sjfricke/MrTruman/README.md

# ECE453Project

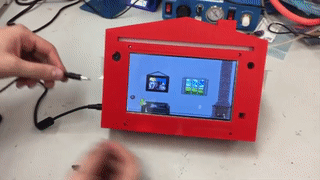
[picture p1: speakers.gif]
Speakers


https://www.youtube.com/watch?v=rOoYeWgOzVc
