sjfricke/MrTruman/Seahaven/docs/project_block_diag.tiff

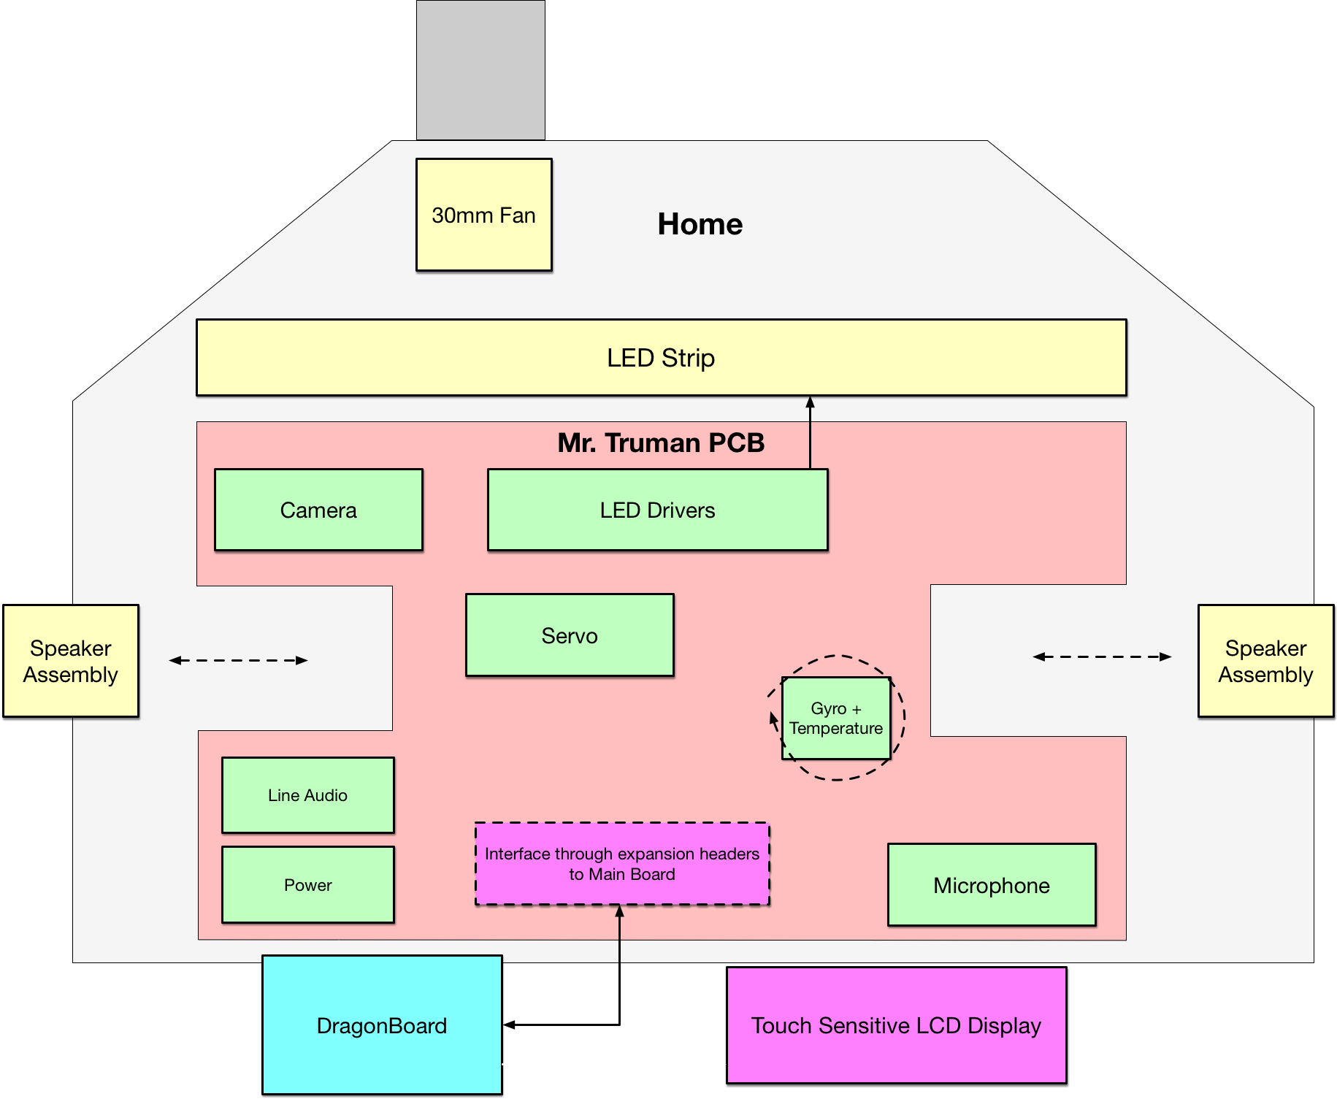
Seahaven/docs/project_block_diag.tiff
