sjfricke/MrTruman/Seahaven/website/res/img/fire_place.png

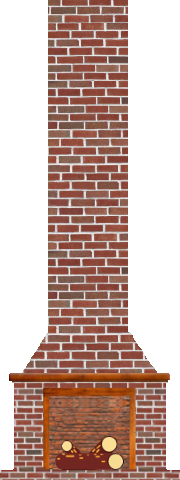
Seahaven/website/res/img/fire_place.png
