sjfricke/MrTruman/Seahaven/website/res/img/flash.png

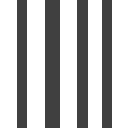
Seahaven/website/res/img/flash.png
