sjfricke/MrTruman/Seahaven/website/res/img/frame.png

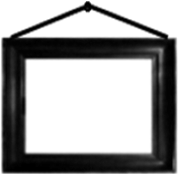
Seahaven/website/res/img/frame.png
