sjfricke/MrTruman/Seahaven/website/res/img/picture.png

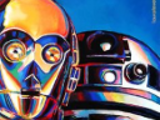
Seahaven/website/res/img/picture.png
