sjfricke/MrTruman/Seahaven/website/res/img/wall_texture_0.jpg

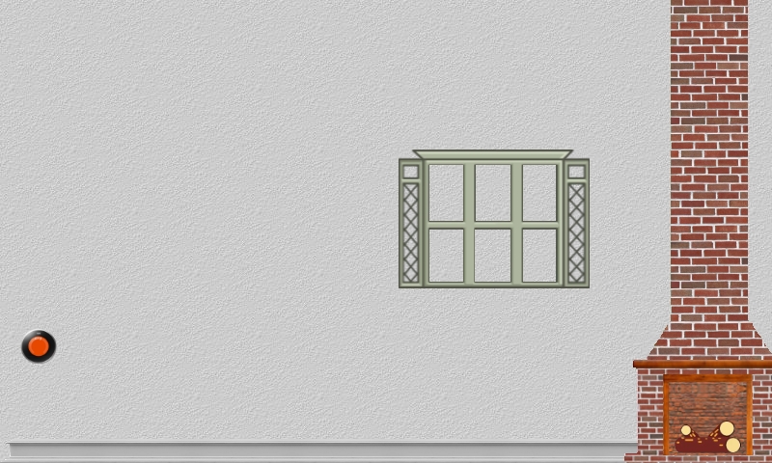
Seahaven/website/res/img/wall_texture_0.jpg
