sjfricke/MrTruman/Seahaven/website/res/img/wall_texture_1.jpg

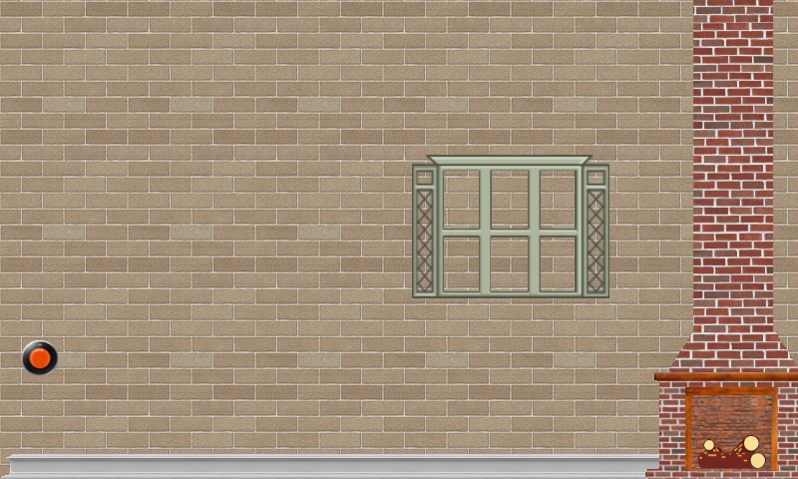
Seahaven/website/res/img/wall_texture_1.jpg
