sjfricke/MrTruman/Seahaven/website/res/img/wall_texture_2.jpg

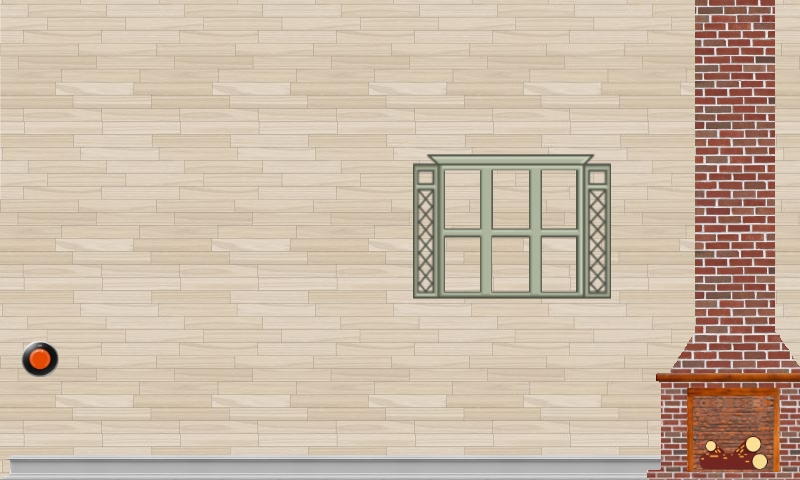
Seahaven/website/res/img/wall_texture_2.jpg
