sjfricke/MrTruman/Seahaven/website/res/img/wall_texture_3.jpg

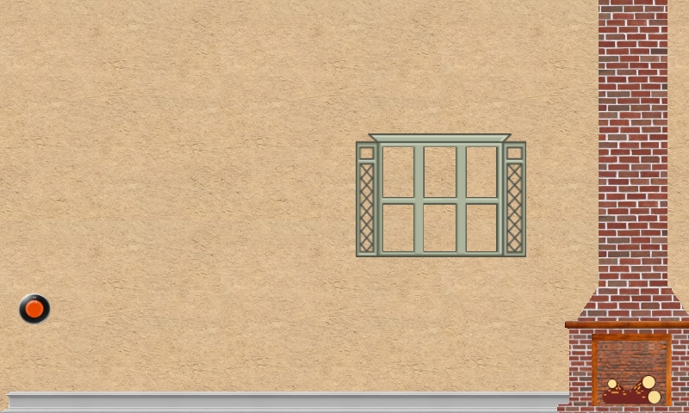
Seahaven/website/res/img/wall_texture_3.jpg
