sjfricke/MrTruman/Seahaven/website/res/img/wall_texture_4.jpg

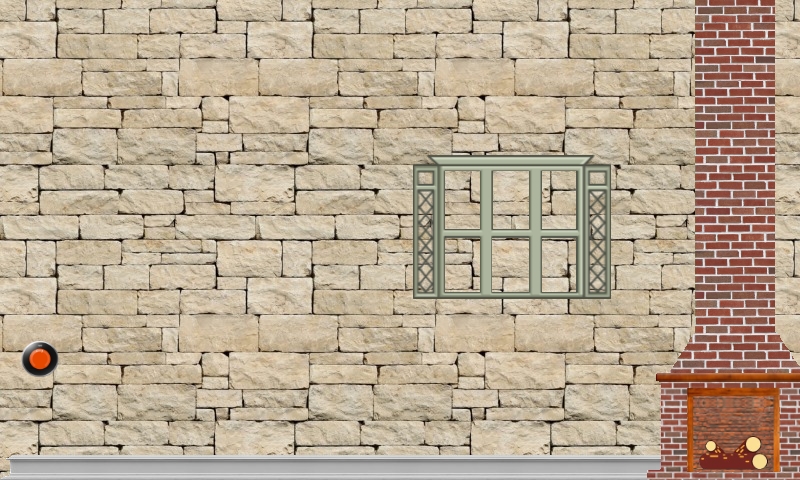
Seahaven/website/res/img/wall_texture_4.jpg
