sjfricke/MrTruman/Seahaven/website/res/img/window.png

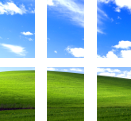
Seahaven/website/res/img/window.png
