sjfricke/MrTruman/Seahaven/website/res/json/spineboy_tex.png

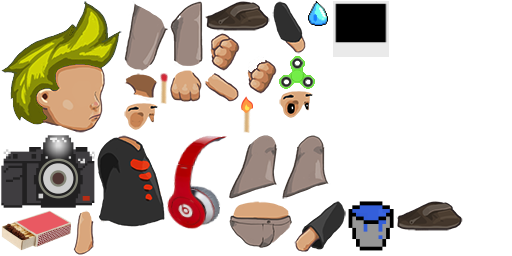
Seahaven/website/res/json/spineboy_tex.png
