sjfricke/MrTruman/Seahaven/website/res/spritesheet/fire_animated.png

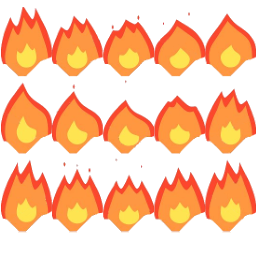
Seahaven/website/res/spritesheet/fire_animated.png
