sjfricke/MrTruman/Seahaven/website/res/spritesheet/flash_animated.png

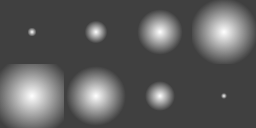
Seahaven/website/res/spritesheet/flash_animated.png
