sjfricke/MrTruman/ALTIUM/MRTRUMAN/Project Outputs for MRTRUMAN/MRTRUMAN_BOM.xlsx

Manufacturer Part Number | Manufacturer | Description | Designator | Quantity | LibRef
MJ-3523-SMT-TR | CUI | 3.50mm (0.141", 1/8", Mini Plug) - Headphone Phone Jack Mono Connector Solder | AUX1 | 1 | CP-3523MJCT-ND
C2012X7T2E104K125AE | TDK | Cap Ceramic 0.1uF 250V X7T 10% SMD 0805 125C Plastic T/R | C1, C2, C5, C6, C20, C27, C29, C30, C32, C36, C37, C38, C41, C42, C46 | 15 | CAP_0805_.1u_250V
160R15X106KV4E | Johanson Dielectrics | Cap Ceramic 10uF 16V X5R 10% SMD 0805 85C T/R | C3, C7, C22, C31, C33, C34, C35, C39, C40, C43, C44, C45, C47 | 13 | CAP_0805_10u_16V
UWT1E221MNL1GS | Nichicon | CAP ALUM 220UF 20% 25V SMD | C4, C8, C9, C10, C11, C12, C13 | 7 | CAP_RAD_220u_25V
C2012X7S2A105K125AE | TDK | CAP CER 1UF 100V X7S 0805 | C14, C16, C24 | 3 | CAP_0805_1u_100V
CL21A226MAQNNNE | Samsung | 22µF ±20% 25V X5R Ceramic Capacitor -55°C ~ 85°C Surface Mount, MLCC 0805 (2012 Metric) 0.079" L x 0.049" W (2.00mm x 1.25mm) | C15, C25 | 2 | CAP_0805_22u_25V
CGJ4J2X7R2A223K125AA | TDK | CAP CER 0.022UF 100V X7R 0805 | C17, C19, C21, C26 | 4 | CAP_0805_22n_100V
GRM32ER61A107ME20L | Murata | Cap Ceramic 100uF 10V X5R 20% SMD 1210 85C Embossed T/R | C18, C23, C28 | 3 | CAP_1210_100u_10V
1-1734248-5 | TE Connectivity | CONN FPC VERT 15POS 1.00MM SMD | CAM1 | 1 | A101418CT-ND
SML-LXR85SIC-TR | Lumex | Standard LEDs - SMD Surface Mount LEDs | D1, D2, D3, D4 | 4 | LED_RED_636nm
WP154A4SUREQBFZGC | Kingbright | WP154A4SUREQBFZGC | D5, D6, D7, D8, D9, D10, D11, D12, D13, D14 | 10 | RGB_LED
N/A | N/A - Just Thru Hole Vias | 4 Position Thru Hole Connection | DPWR1 | 1 | Display_Power
ASB0305MA-CA8Z | Delta Design | FAN AXIAL 30X10MM 5VDC WIRE | FAN1 | 1 | ASB0305MA-CA8Z
MFU0805FF01000P100 | Vishay | FUSE 1.00A 0805 VFAST SMD | FUSE1 | 1 | FUSE_0805_1A_32VDC
57202-G52-20LF | Amphenol FCI | 40 Positions Header, Unshrouded Connector 0.079" (2.00mm) Surface Mount Gold, GXT™ | J1 | 1 | DragonBoard_LOW_SPEED
61083-064402LF | Amphenol FCI | 60 Position Connector Plug, Center Strip Contacts Surface Mount Gold | J2 | 1 | DragonBoard_HIGH_SPEED
0791091007 | Molex | Conn Socket Strip RCP 16 POS 2mm Solder ST SMD Tube | J3 | 1 | DragonBoard_ANALOG
SPU0410HR5H-PB | Knowles | MIC MEMS ANALOG OMNI -42DB | MIC1 | 1 | SPU0410HR5H-PB
EJ503A | Memory Protection Devices | DC Barrel Jack 2.1mm x 5.5mm 12V 5A | PWR1 | 1 | EJ503A
RC0805FR-071M74L | Yageo | RES SMD 1.74M OHM 1% 1/8W 0805 | R1, R21 | 2 | RES_0805_1.74M
RC0805FR-076K2L | Yageo | Yageo RC0805 Series Thick Film Surface Mount Resistor 0805 Case 6.2k 1% 0.125W 100ppm/C | R2 | 1 | RES_0805_6.2K
RC0805FR-071M43L | Yageo | RES SMD 1.43M OHM 1% 1/8W 0805 | R3 | 1 | RES_0805_1.43M
RC0805JR-072KL | Yageo | RES SMD 2K OHM 5% 1/8W 0805 | R4, R23 | 2 | RES_0805_2K
ERJ-6ENF2322V | Panasonic ECG | RESISTOR, THICK FILM, 23.2KOHM, 125mW, ± 1% | R5, R14 | 2 | RES_0805_23.2K
RC0805FR-0763K4L | Yageo | RES SMD 63.4K OHM 1% 1/8W 0805 | R6 | 1 | RES_0805_63.4K
ERJ-6ENF2263V | Panasonic ECG | Res Thick Film 0805 226K Ohm 1% 1/8W ±100ppm/C Molded SMD Punched Carrier T/R | R7 | 1 | RES_0805_226K
CRCW0805549KFKEA | Vishay | RES SMD 549K OHM 1% 1/8W 0805 | R8 | 1 | RES_0805_549K
RC0805FR-0711K8L | Yageo | RES SMD 11.8K OHM 1% 1/8W 0805 | R9, R17, R29 | 3 | RES_0805_11.8K
RC0805FR-07787RL | Yageo | RES SMD 787 OHM 1% 1/8W 0805 | R10, R11, R20, R22 | 4 | RES_0805_787
RC0805FR-075K23L | Yageo | Thick Film Resistors 5.23K OHM 1% | R12 | 1 | RES_0805_5.23K
RC0805FR-071KL | Yageo | RES SMD 1K OHM 1% 1/8W 0805 | R13 | 1 | RES_0805_1K
ERJ-6ENF1003V | Panasonic ECG | Res Thick Film 0805 100K Ohm 1% 0.125W(1/8W) ±100ppm/C Molded SMD Automotive Punched T/R | R15 | 1 | RES_0805_100K
ERJ-6ENF1134V | Panasonic | Res Thick Film 0805 1.13M Ohm 1% 1/8W 100ppm/C Molded SMD Punched Carrier T/R | R16 | 1 | RES_0805_1.13M
RC0805FR-07255KL | Yageo | RES SMD 255K OHM 1% 1/8W 0805 | R18 | 1 | RES_0805_255K
RC0805FR-07887KL | Yageo | Thick Film Resistors - SMD 887K OHM 1% | R19 | 1 | RES_0805_887K
RMCF0805FT499R | Stackpole Electronics | Res Thick Film 0805 499 Ohm 1% 0.125W(1/8W) ±100ppm/C Molded SMD Automotive T/R | R24, R26 | 2 | RES_0805_499
RMCF0805JT1K20 | Stackpole Electronics | Res Thick Film 0805 1.2K Ohm 5% 0.125W(1/8W) ±200ppm/C Molded SMD Automotive T/R | R25, R28 | 2 | RES_0805_1.2K
RC0805JR-070RL | Yageo | RES, THICK FILM, 0R, 0.125W, 0805 | R27, R30, R31, R32, R33 | 5 | RES_0805_JMP
RC0805FR-07309RL | Yageo | RES SMD 309 OHM 1% 1/8W 0805 | R34, R35, R40, R41, R46, R47, R52, R53, R58, R61 | 10 | RES_0805_309
RC0805FR-07169RL | Yageo | RES SMD 169 OHM 1% 1/8W 0805 | R36, R37, R38, R39, R42, R43, R44, R45, R48, R49, R50, R51, R54, R55, R56, R57, R59, R60, R62, R63 | 20 | RES_0805_169
61300311121 | Wurth Electronics | Board-To-Board Connector, Vertical, WR-PHD Series, Through Hole, Header, 3 Contacts, 2.54 mm | SERVO1 | 1 | Servo_Header
CDS-27204-L100 | CUI | 4 Ohm Magnetic Speaker 2W 20Hz ~ 20kHz Top Rectangular 93dB | SPKR1, SPKR2 | 2 | CDS-27204-L100
1625854-4 | TE Connectivity | Testpoint_1206 | TP1, TP2, TP3, TP4, TP5, TP6, TP7, TP8, TP9, TP10, TP11, TP12, TP13, TP14, TP15, TP16, TP17, TP18, TP19, TP20, TP21, TP22, TP23, TP24, TP25, TP26, TP27, TP28, TP29, TP30, TP31, TP32, TP33, TP34, TP35, TP36, TP37, TP38, TP39, TP40, TP41, TP42, TP43, TP44, TP45, TP46, TP47, TP48, TP49, TP50, TP51, TP52, TP53, TP54, TP55, TP56, TP57, TP58, TP59, TP60, TP61, TP62, TP63, TP64, TP65, TP66, TP67, TP68, TP69, TP70, TP71, TP72, TP73, TP74, TP75, TP76, TP77, TP78, TP79, TP80, TP81, TP82, TP83, TP84, TP85, TP86, TP87, TP88, TP89, TP90, TP91, TP92, TP93, TP94, TP95, TP96 | 96 | TP
TXS0108EPWR | Texas Instruments | TRANSLATOR, VOLTAGE, 8BIT, 20TSSOP | U1, U2 | 2 | TXS0108
LMZ12003TZ-ADJ/NOPB | Texas Instruments | POWER MODULE, TO-PMOD-7, FULL REEL | U3, U5 | 2 | LMZ12003
TPS3779BDBVT | Texas Instruments | Voltage Detector, Active-Low, Push-Pull Reset, 2-Monitors, 1.5V-6.5Vin, SOT-23-6 | U4, U6 | 2 | TPS3779BDBVR
LSM6DS3HTR | STMicroelectronics | Accelerometer and Gyroscope 14-Pin LGA T/R | U7 | 1 | LSM6DS3HTR
PCA9685PW,118 | NXP Semiconductors | IC LED DRIVER RGBA 28-TSSOP | U8, U11, U12, U13 | 4 | PCA9685PW
AD7684BRMZRL7 | Analog Devices | IC ADC 16BIT 100KSPS DIFF 8MSOP | U9 | 1 | AD7684BRMZRL7CT-ND
AD8138ARZ-R7 | Analog Devices | SP Amp Differential ADC Driver Single ±5.5V/11V 8-Pin SOIC N T/R | U10 | 1 | AD8138ARZ-R7CT-ND
