sjfricke/MrTruman/3D_Prints/week06_draft/truman_06_full.stl

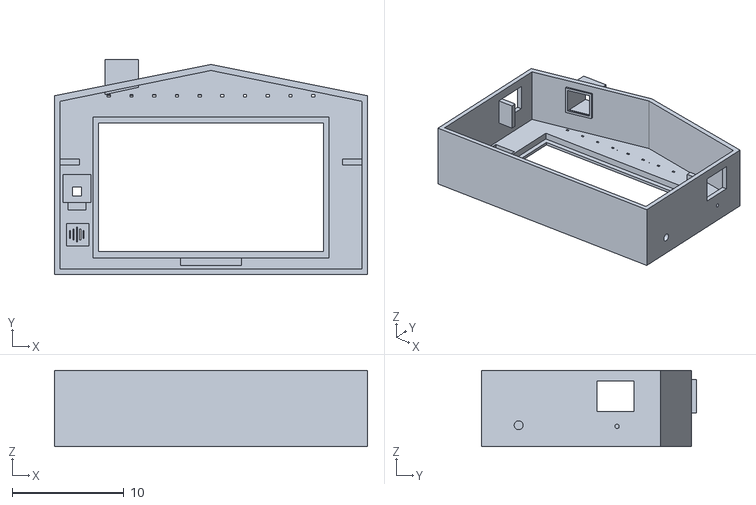
[picture p17: CAD file, 2017-11-06]
3D_Prints/week06_draft/truman_06_full.stl
28.0 x 19.2 x 6.80
