sjfricke/MrTruman/3D_Prints/Final_draft/back_plate_full.stl

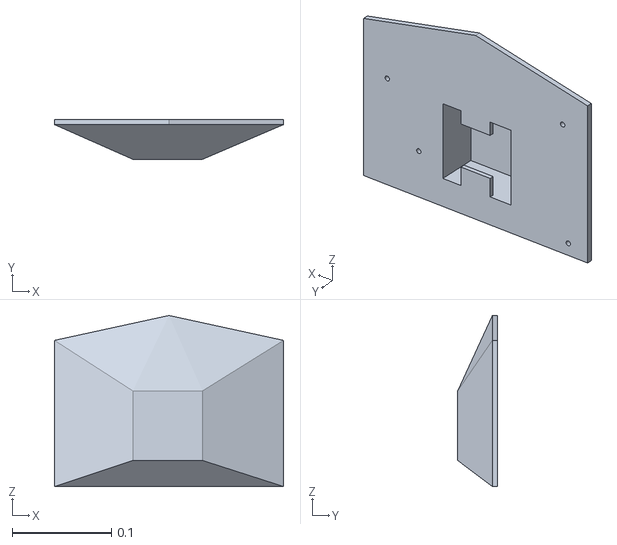
[picture p18: CAD file, 2017-11-27]
3D_Prints/Final_draft/back_plate_full.stl
0.231 x 0.04 x 0.172
