sjfricke/MrTruman/3D_Prints/Final_draft/house_front_full.stl

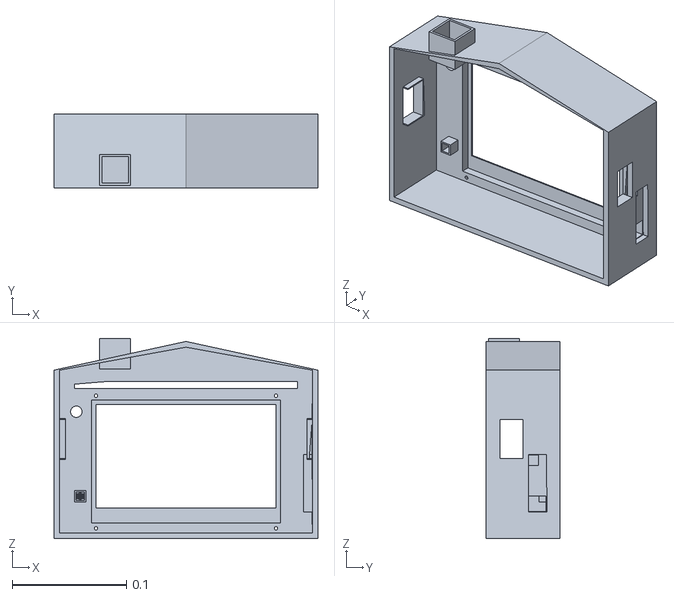
[picture p19: CAD file, 2017-11-27]
3D_Prints/Final_draft/house_front_full.stl
0.231 x 0.065 x 0.175
