sjfricke/MrTruman/3D_Prints/Final_draft/back_plate_left_test.stl

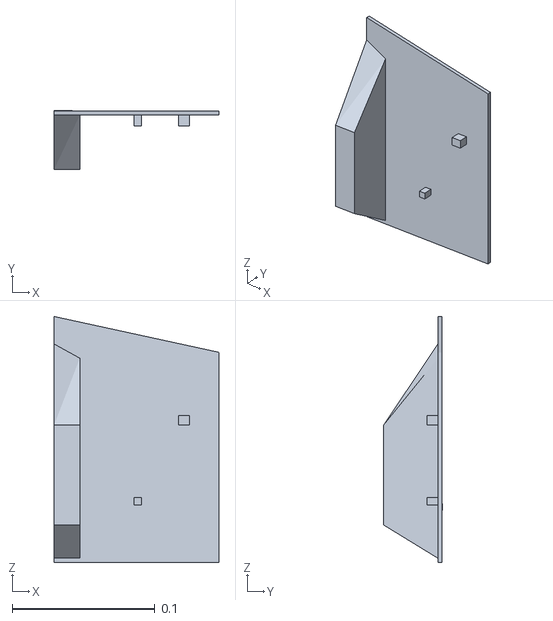
[picture p20: CAD file, 2017-11-29]
3D_Prints/Final_draft/back_plate_left_test.stl
0.116 x 0.0411 x 0.172
