sjfricke/MrTruman/3D_Prints/week05_draft/week05_draft_right_slim.stl

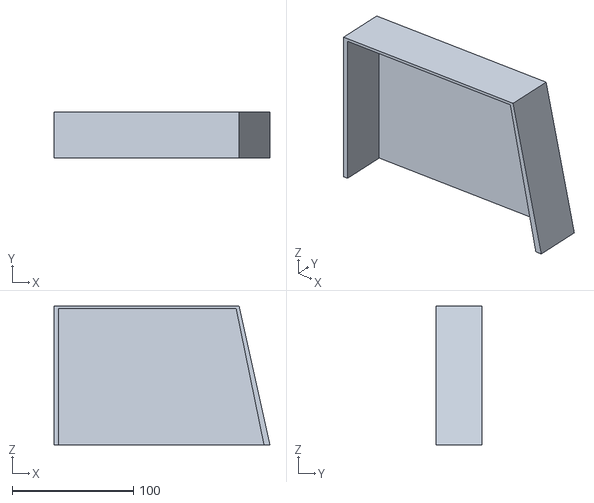
[picture p21: CAD file, 2017-11-06]
3D_Prints/week05_draft/week05_draft_right_slim.stl
177.8 x 38.1 x 114.3
