sjfricke/MrTruman/3D_Prints/Final_draft/awning.stl

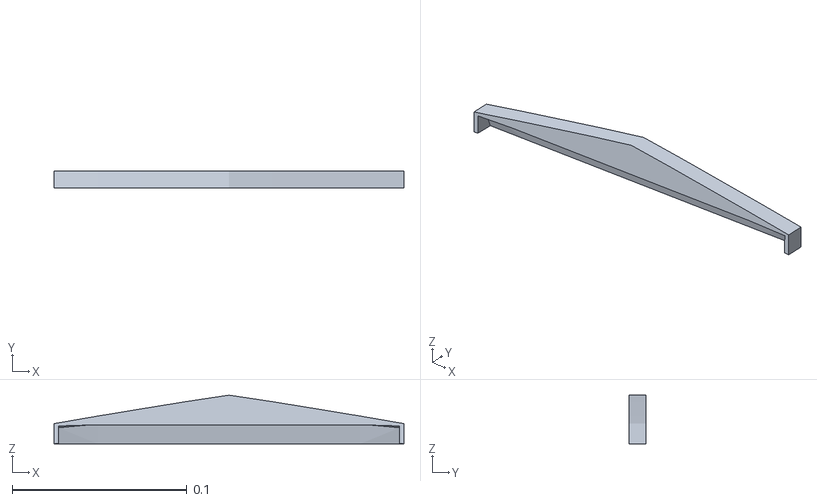
[picture p23: CAD file, 2017-11-29]
3D_Prints/Final_draft/awning.stl
0.2 x 0.01 x 0.0278
