sjfricke/MrTruman/3D_Prints/week05_draft/week05_draft_right.stl

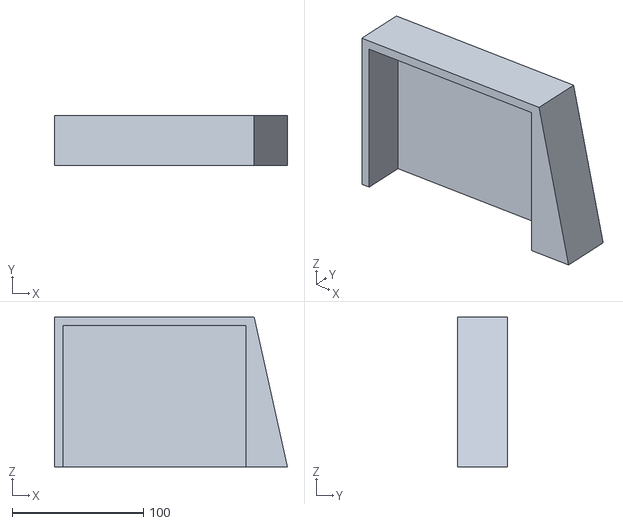
[picture p24: CAD file, 2017-11-06]
3D_Prints/week05_draft/week05_draft_right.stl
177.8 x 38.1 x 114.3
