sjfricke/MrTruman/3D_Prints/week06_draft/truman_06_Right.stl

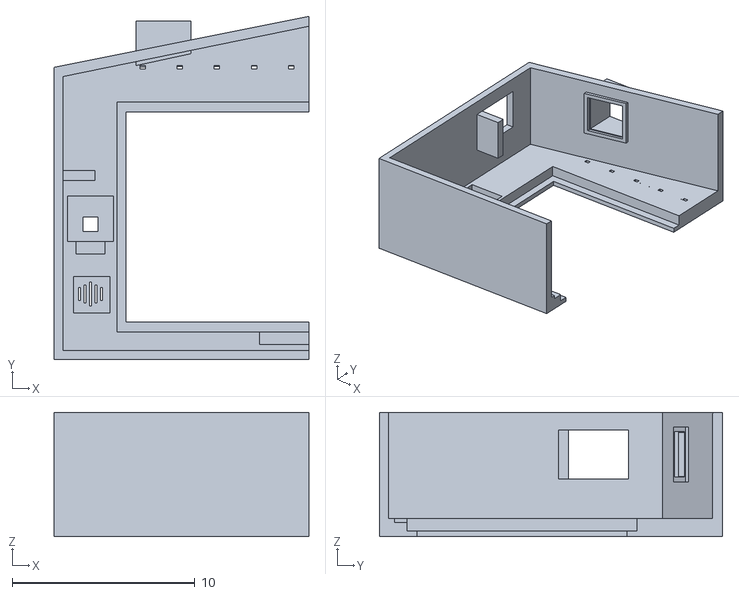
[picture p25: CAD file, 2017-11-06]
3D_Prints/week06_draft/truman_06_Right.stl
14.0 x 18.8 x 6.80
