sjfricke/MrTruman/3D_Prints/week05_draft/week05_draft_left.stl

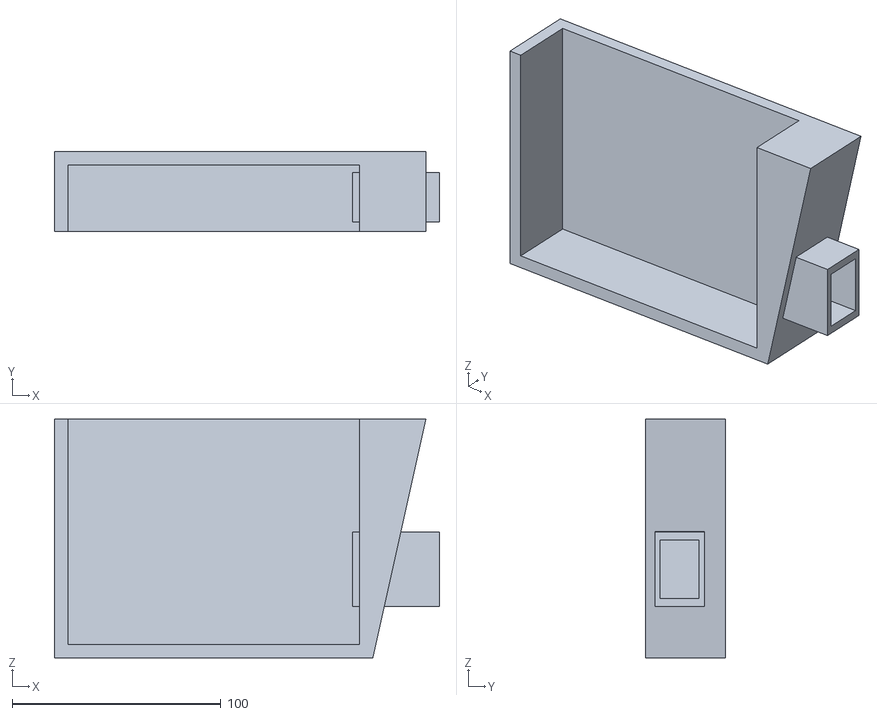
[picture p26: CAD file, 2017-11-06]
3D_Prints/week05_draft/week05_draft_left.stl
184.3 x 38.1 x 114.3
