sjfricke/MrTruman/3D_Prints/Final_draft/House_backplates.curaproject.3mf

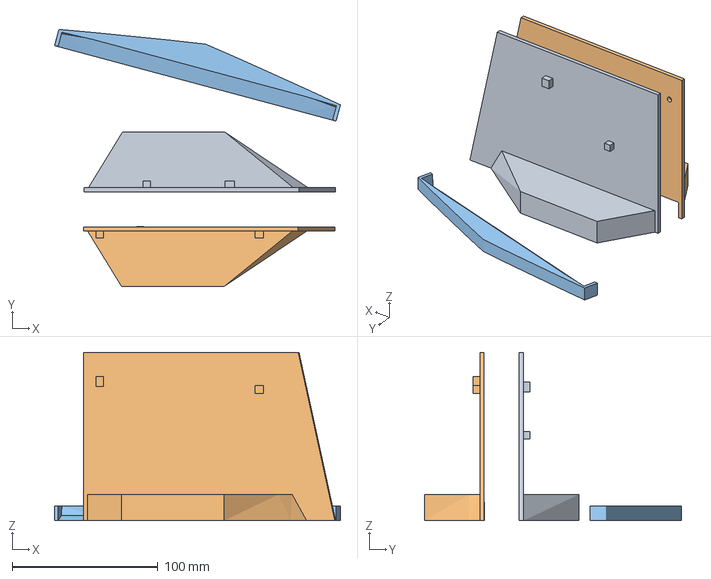
[picture p27: CAD file, 2017-11-29]
3D_Prints/Final_draft/House_backplates.curaproject.3mf
196.2 x 176.4 x 115.5 mm
