sjfricke/MrTruman/3D_Prints/week05_draft/week05_draft_left_slim.stl

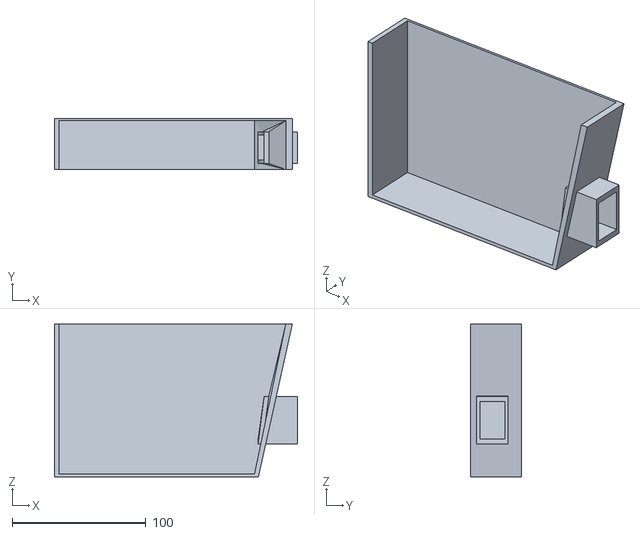
[picture p28: CAD file, 2017-11-06]
3D_Prints/week05_draft/week05_draft_left_slim.stl
181.6 x 38.1 x 114.3
