sjfricke/MrTruman/3D_Prints/Final_draft/House_Backplates_v2.curaproject.3mf

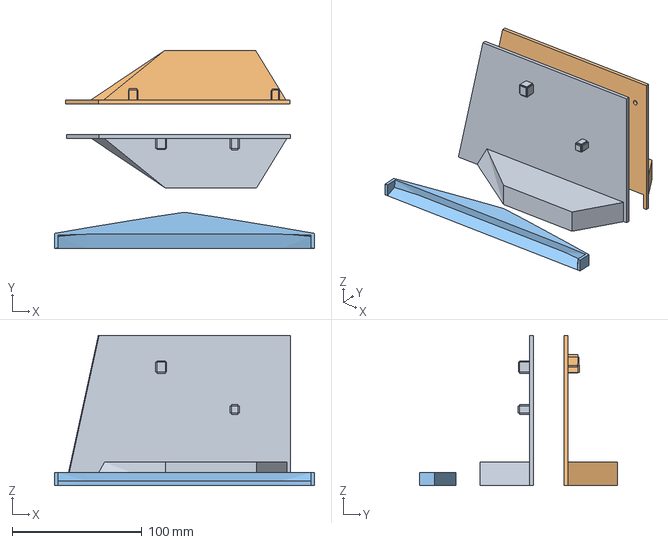
[picture p29: CAD file, 2017-11-29]
3D_Prints/Final_draft/House_Backplates_v2.curaproject.3mf
200.0 x 152.2 x 115.5 mm
