sjfricke/MrTruman/3D_Prints/Final_draft/House_front_cura.curaproject.3mf

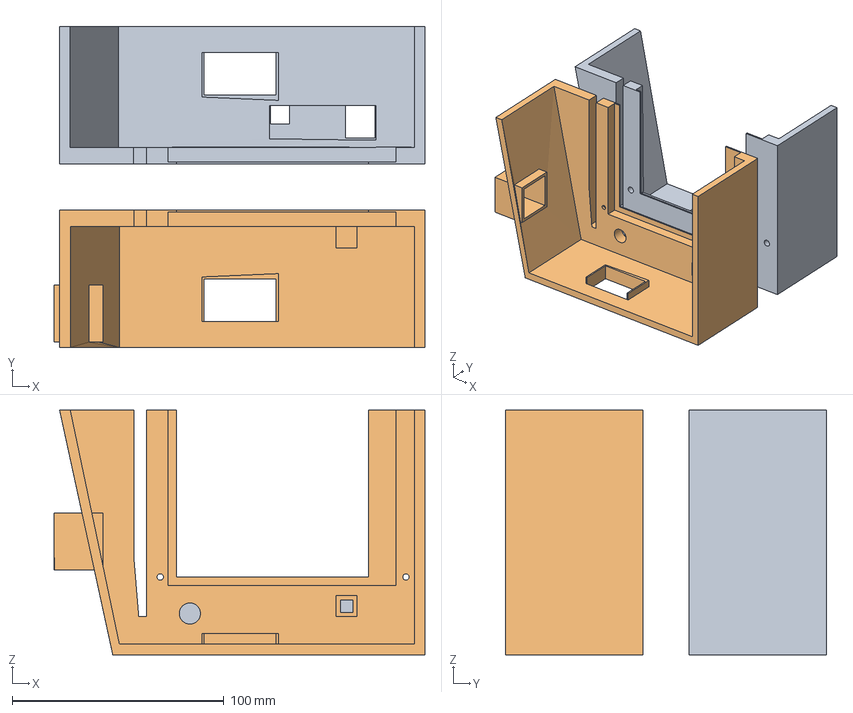
[picture p30: CAD file, 2017-11-27]
3D_Prints/Final_draft/House_front_cura.curaproject.3mf
175.2 x 151.5 x 115.5 mm
