sjfricke/MrTruman/3D_Prints/Final_draft/speaker.stl

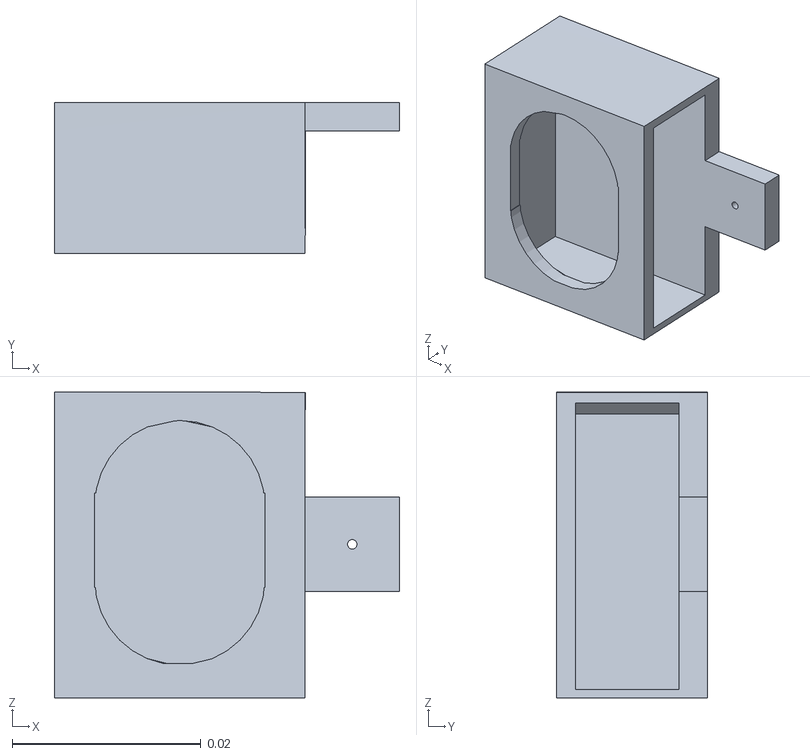
[picture p31: CAD file, 2017-11-27]
3D_Prints/Final_draft/speaker.stl
0.0365 x 0.016 x 0.0324
