sjfricke/MrTruman/3D_Prints/Final_draft/house_front_right.stl

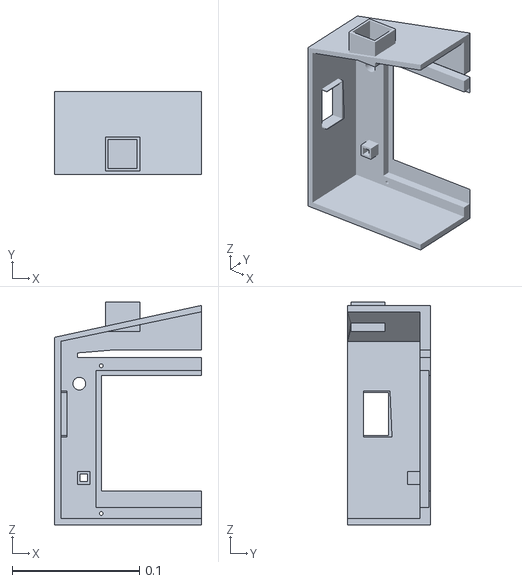
[picture p32: CAD file, 2017-11-27]
3D_Prints/Final_draft/house_front_right.stl
0.116 x 0.065 x 0.175
