sjfricke/MrTruman/3D_Prints/Final_draft/house_front_left.stl

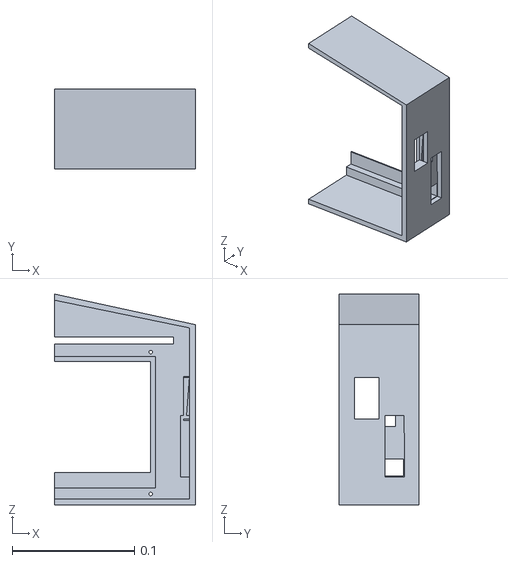
[picture p33: CAD file, 2017-11-27]
3D_Prints/Final_draft/house_front_left.stl
0.116 x 0.065 x 0.172
