sjfricke/MrTruman/3D_Prints/Final_draft/speaker_v2.stl

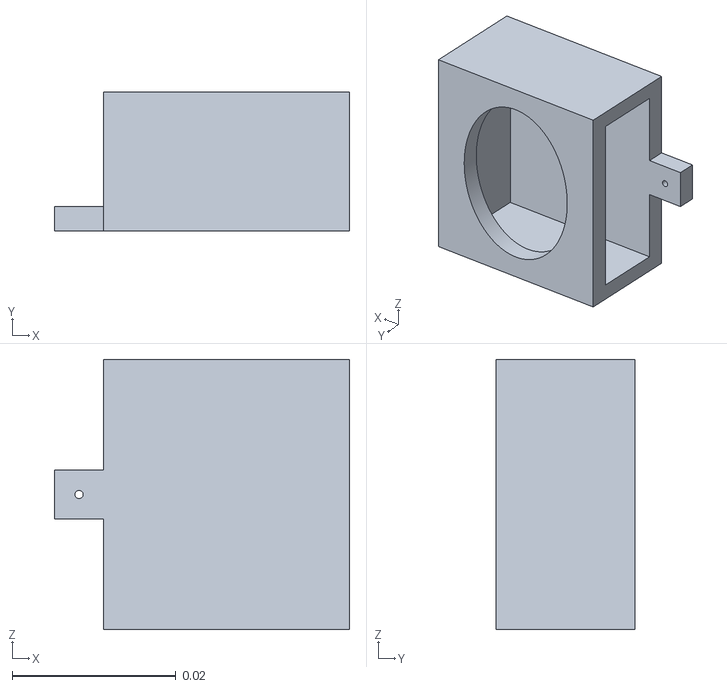
[picture p34: CAD file, 2017-11-27]
3D_Prints/Final_draft/speaker_v2.stl
0.036 x 0.017 x 0.033
