sjfricke/MrTruman/3D_Prints/Final_draft/speakers_awning.curaproject.3mf

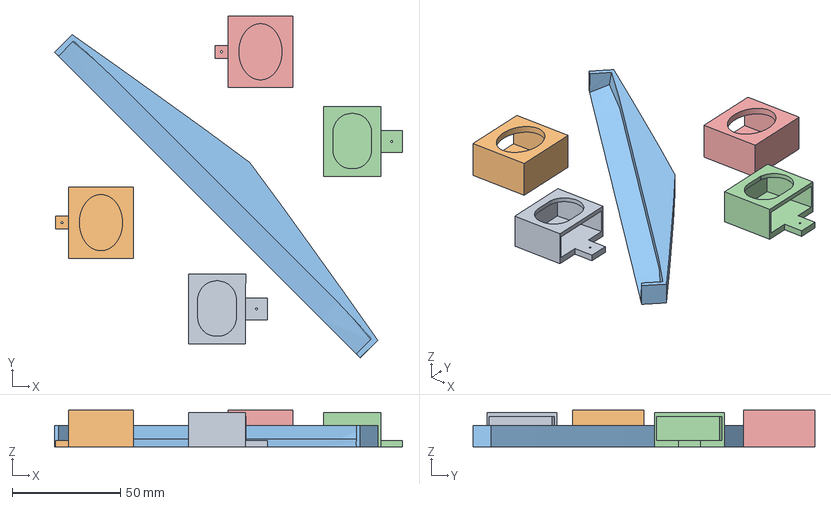
[picture p35: CAD file, 2017-11-27]
3D_Prints/Final_draft/speakers_awning.curaproject.3mf
161.0 x 158.1 x 17.0 mm
