sjfricke/MrTruman/3D_Prints/Final_draft/final_v1_PCB.stl

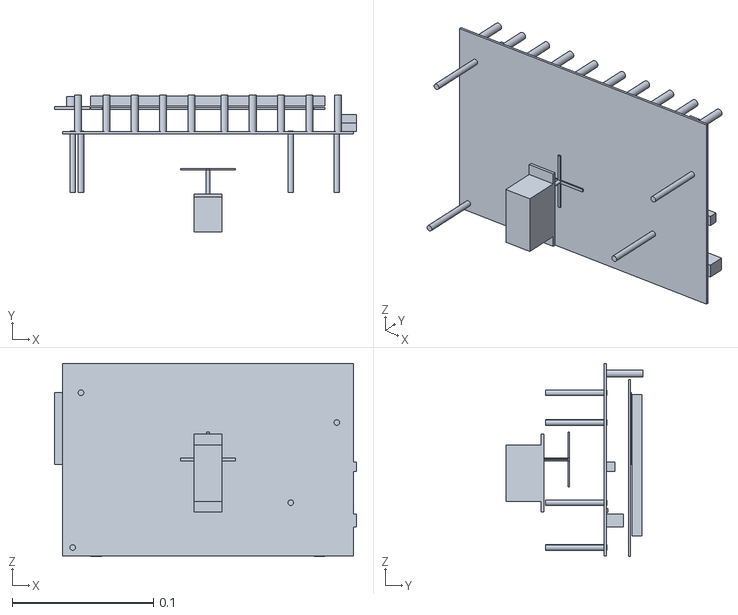
[picture p36: CAD file, 2017-11-22]
3D_Prints/Final_draft/final_v1_PCB.stl
0.214 x 0.0971 x 0.137
