sjfricke/MrTruman/(list of files, cad)

Other CAD files:
3D_Prints/Final_draft/back_plate_right.stl
3D_Prints/Final_draft/back_plate_left.stl
3D_Prints/Final_draft/back_plate_left2.stl
3D_Prints/Final_draft/back_plate_right2.stl
3D_Prints/Final_draft/final_v1.blend
3D_Prints/Final_draft/final_v1_FINISH.blend
3D_Prints/Final_draft/final_v1_PCB.blend
3D_Prints/week06_draft/truman_06.blend
3D_Prints/week06_draft/truman_06_Left.blend
3D_Prints/week06_draft/truman_06_Right.blend
