sjfricke/MrTruman/3D_Prints/diagrams/camera.png

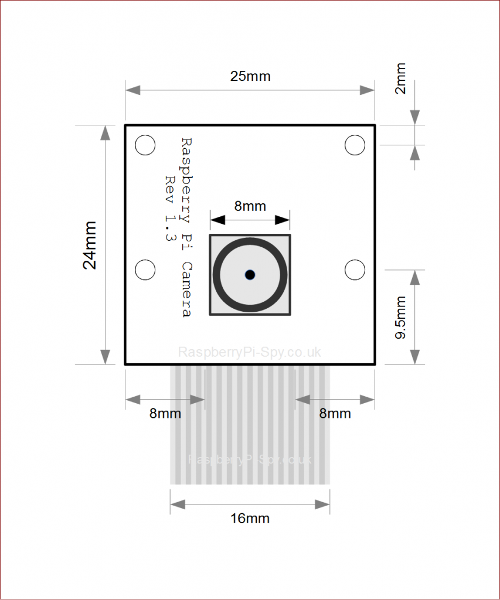
3D_Prints/diagrams/camera.png
