sjfricke/MrTruman/Schematics.PDF

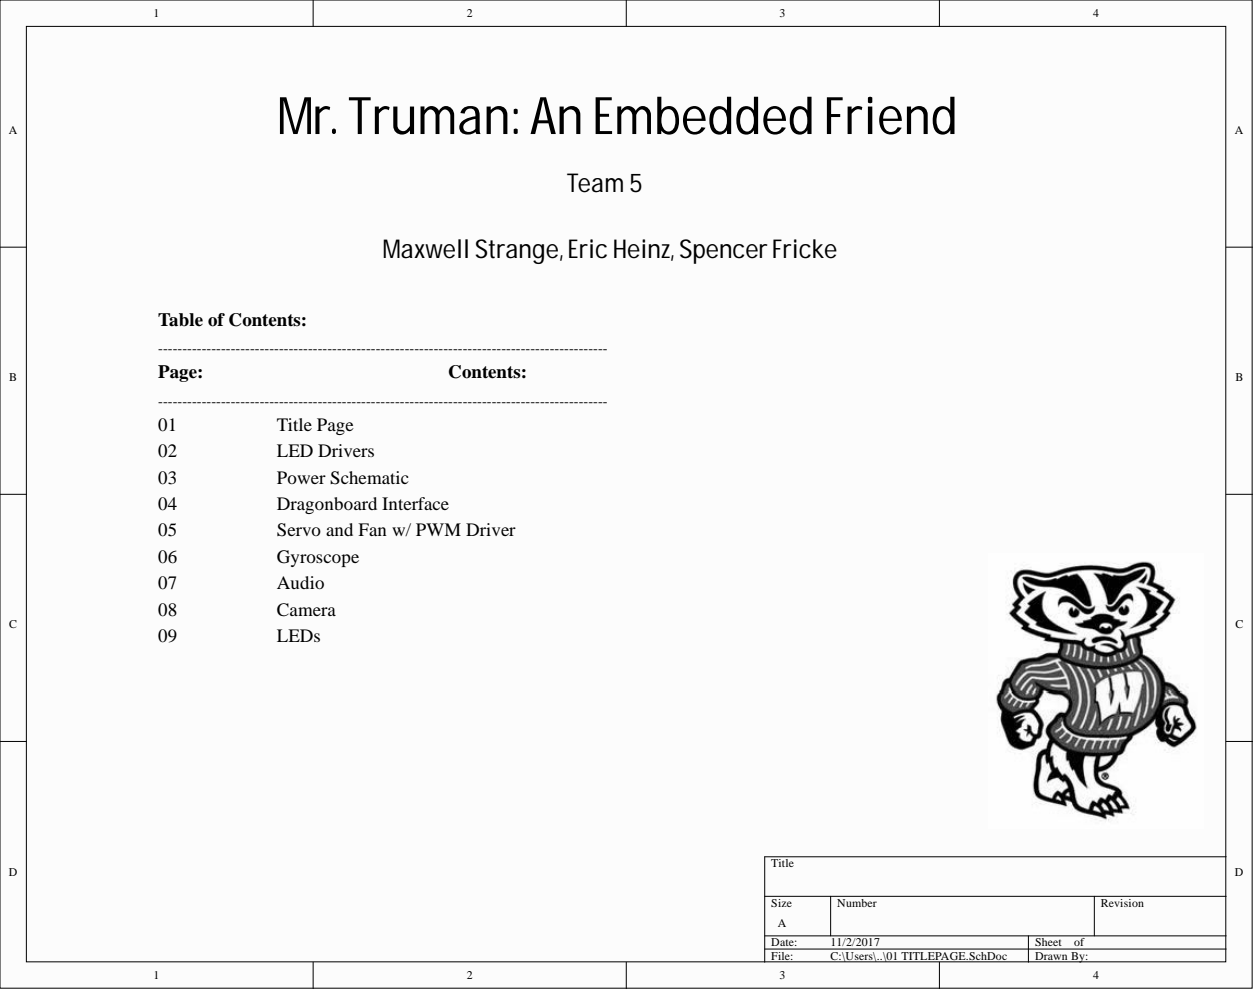
[picture p39: page 1]

Mr. Truman: An Embedded Friend

Maxwell Strange, Eric Heinz, Spencer Fricke

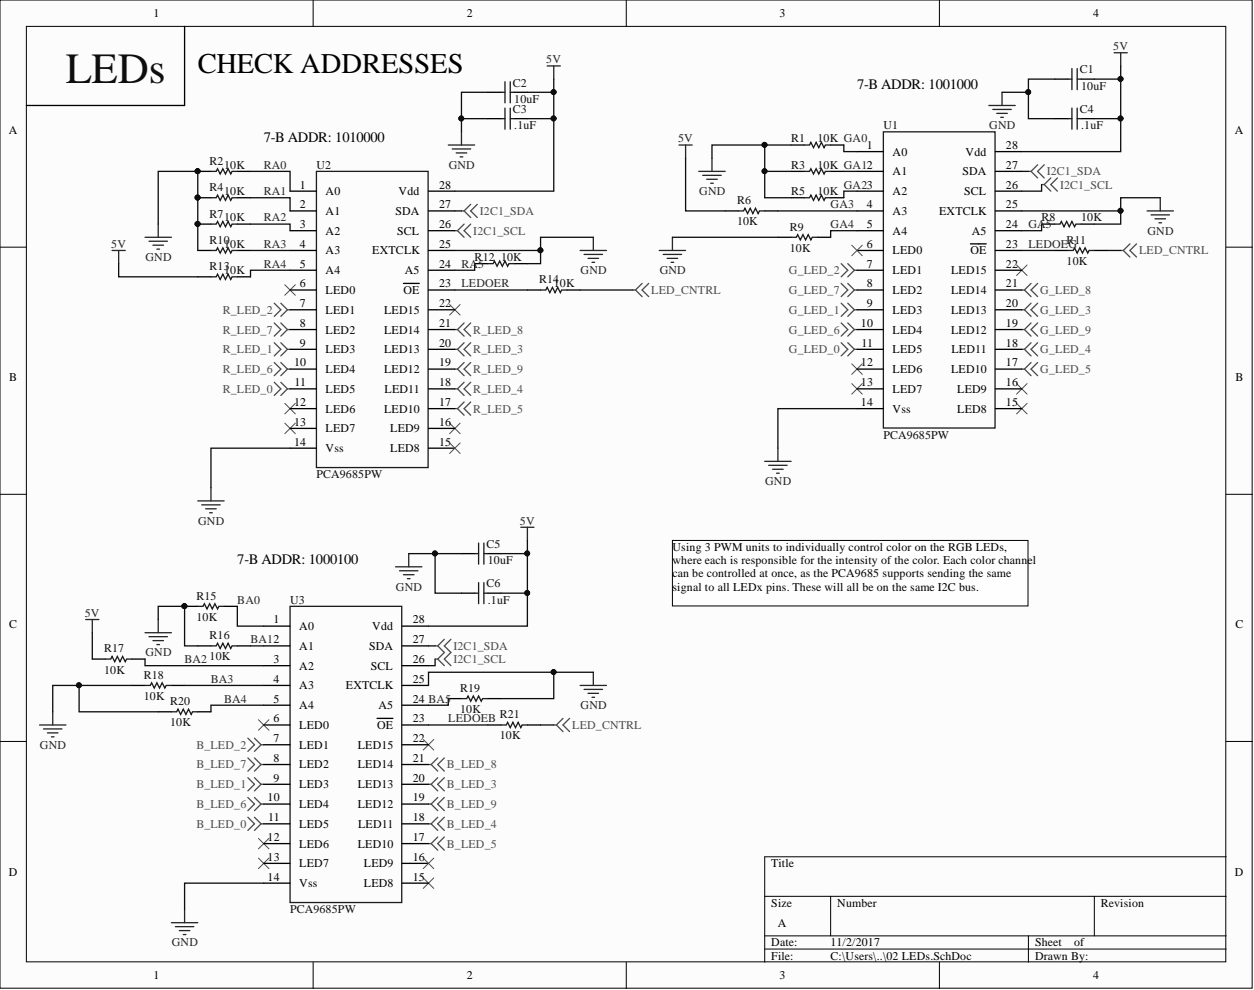
[picture p40: page 2]

Using 3 PWM units to individually control color on the RGB LEDs,
where each is responsible for the intensity of the color. Each color channel
can be controlled at once, as the PCA9685 supports sending the same
signal to all LEDx pins. These will all be on the same I2C bus.

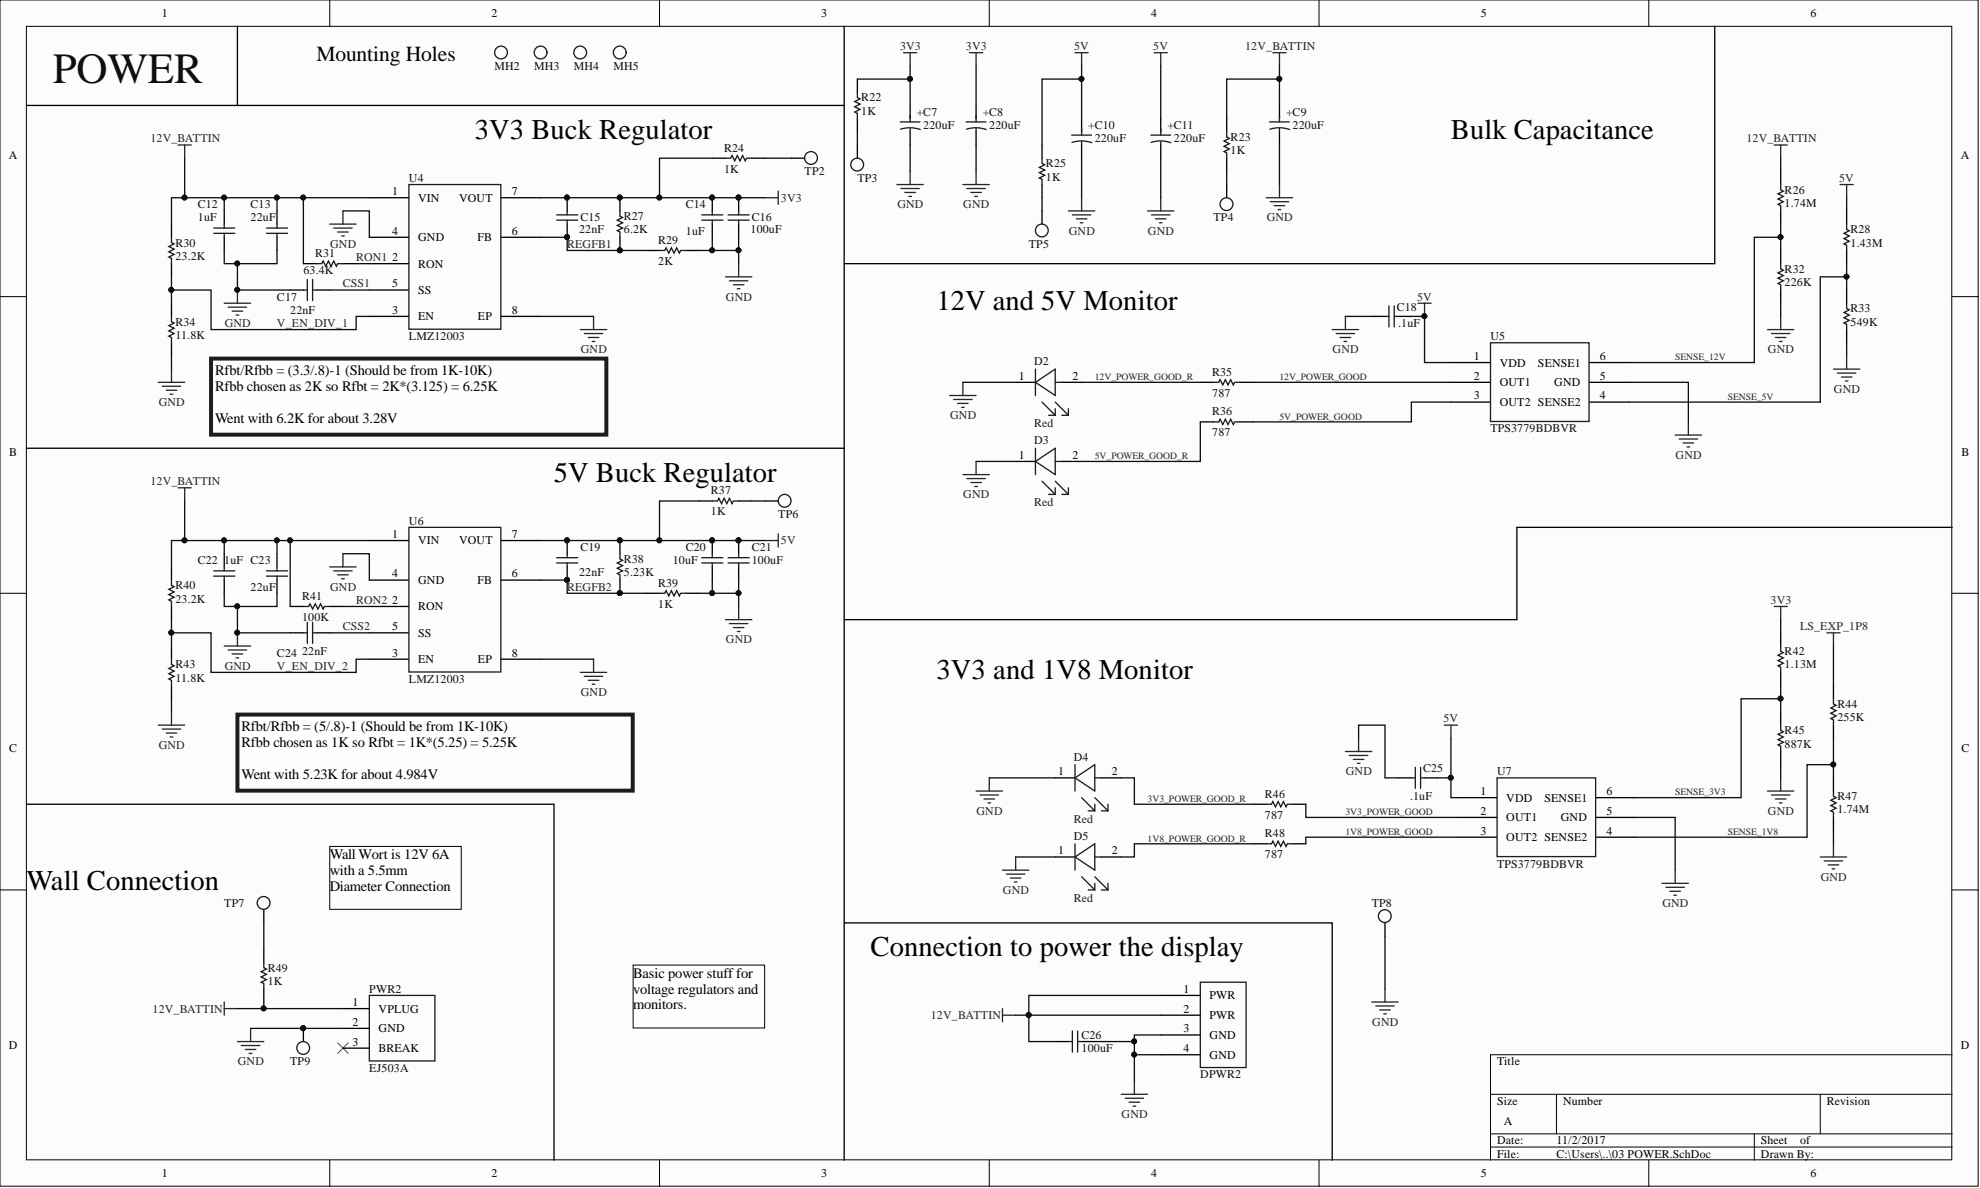
[picture p41: page 3]

Rfbt/Rfbb = (3.3/.8)-1 (Should be from 1K-10K)
Rfbb chosen as 2K so Rfbt = 2K*(3.125) = 6.25K

Went with 6.2K for about 3.28V

Rfbt/Rfbb = (5/.8)-1 (Should be from 1K-10K)
Rfbb chosen as 1K so Rfbt = 1K*(5.25) = 5.25K

Went with 5.23K for about 4.984V

Connection to power the display

Basic power stuff for
voltage regulators and
monitors.

GND 2

GND 3
GND 4

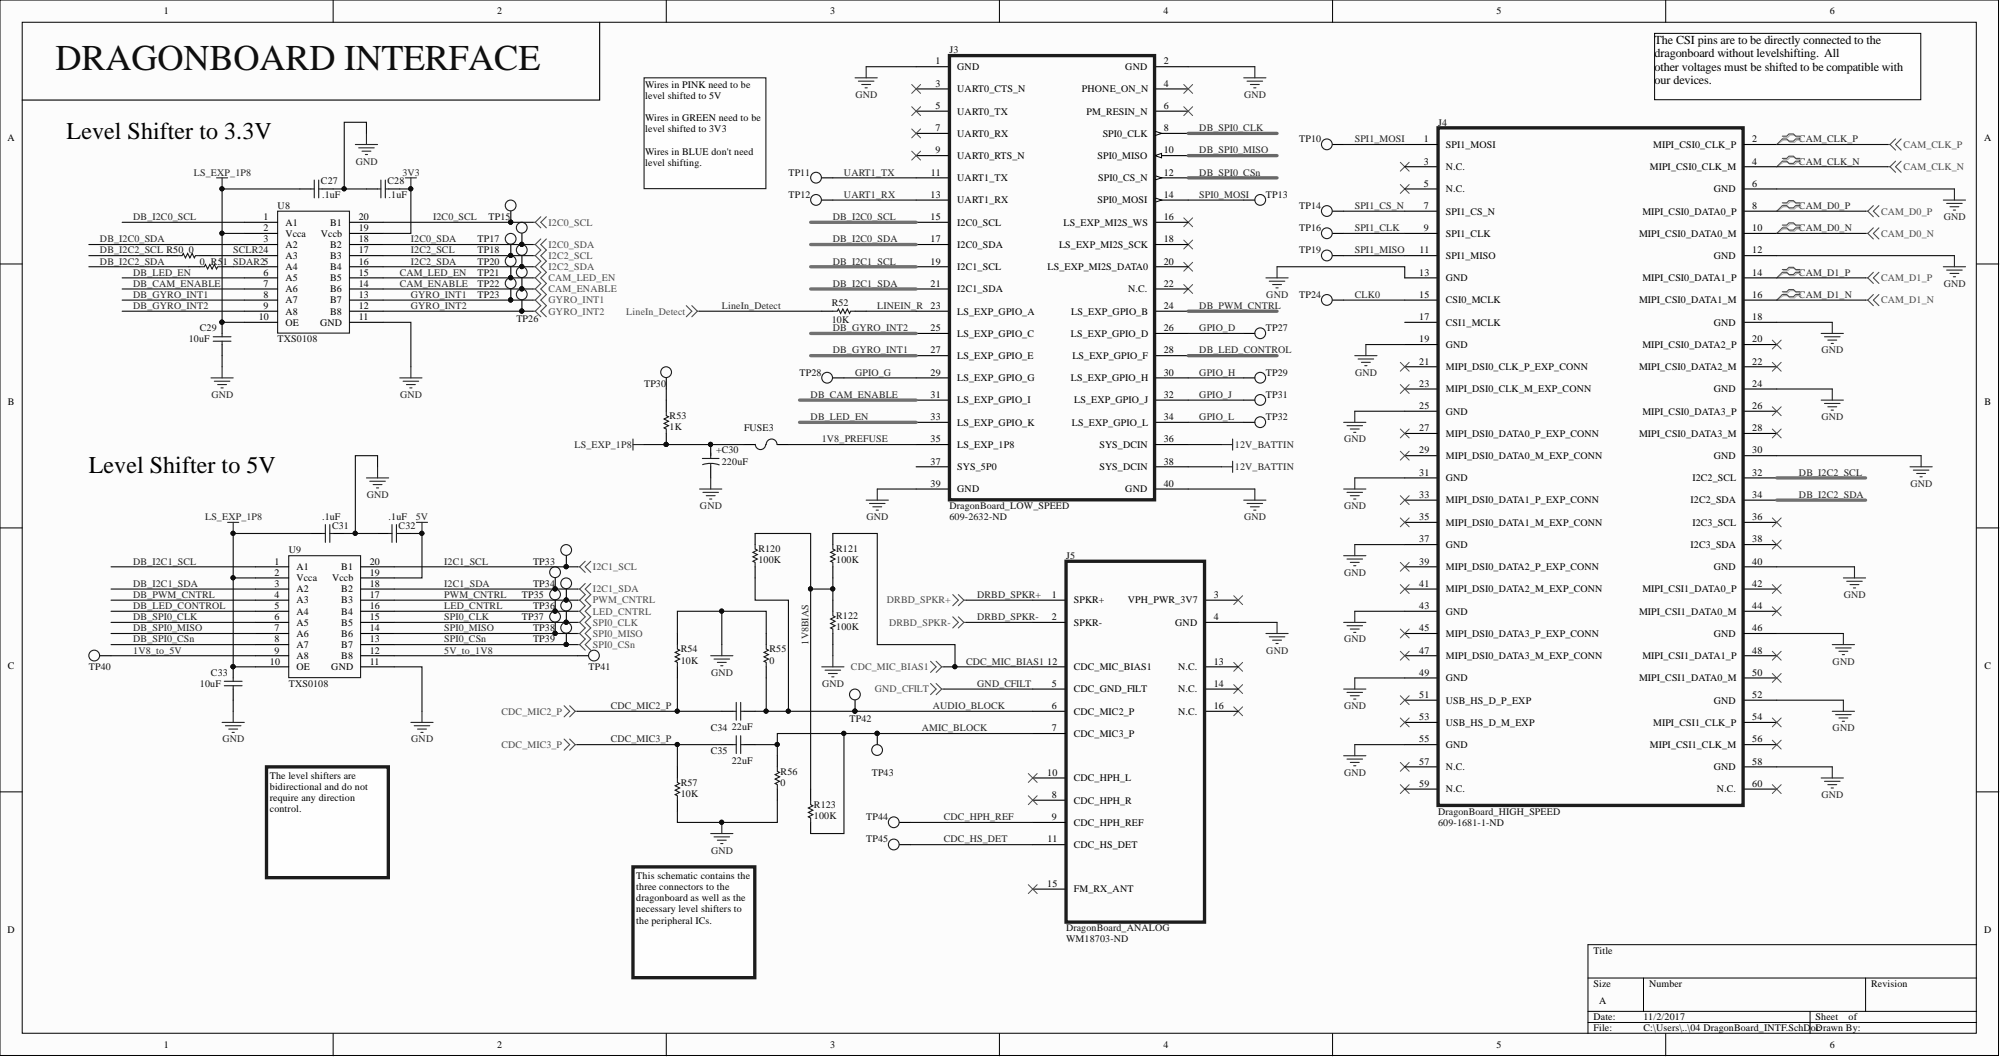
[picture p42: page 4]

The CSI pins are to be directly connected to the
dragonboard without levelshifting. All
other voltages must be shifted to be compatible with
our devices.

Wires in PINK need to be
level shifted to 5V

Wires in GREEN need to be
level shifted to 3V3

Wires in BLUE don't need
level shifting.

A1 1 Vcca 2

The level shifters are
bidirectional and do not
require any direction
control.

This schematic contains the
three connectors to the
dragonboard as well as the
necessary level shifters to
the peripheral ICs.

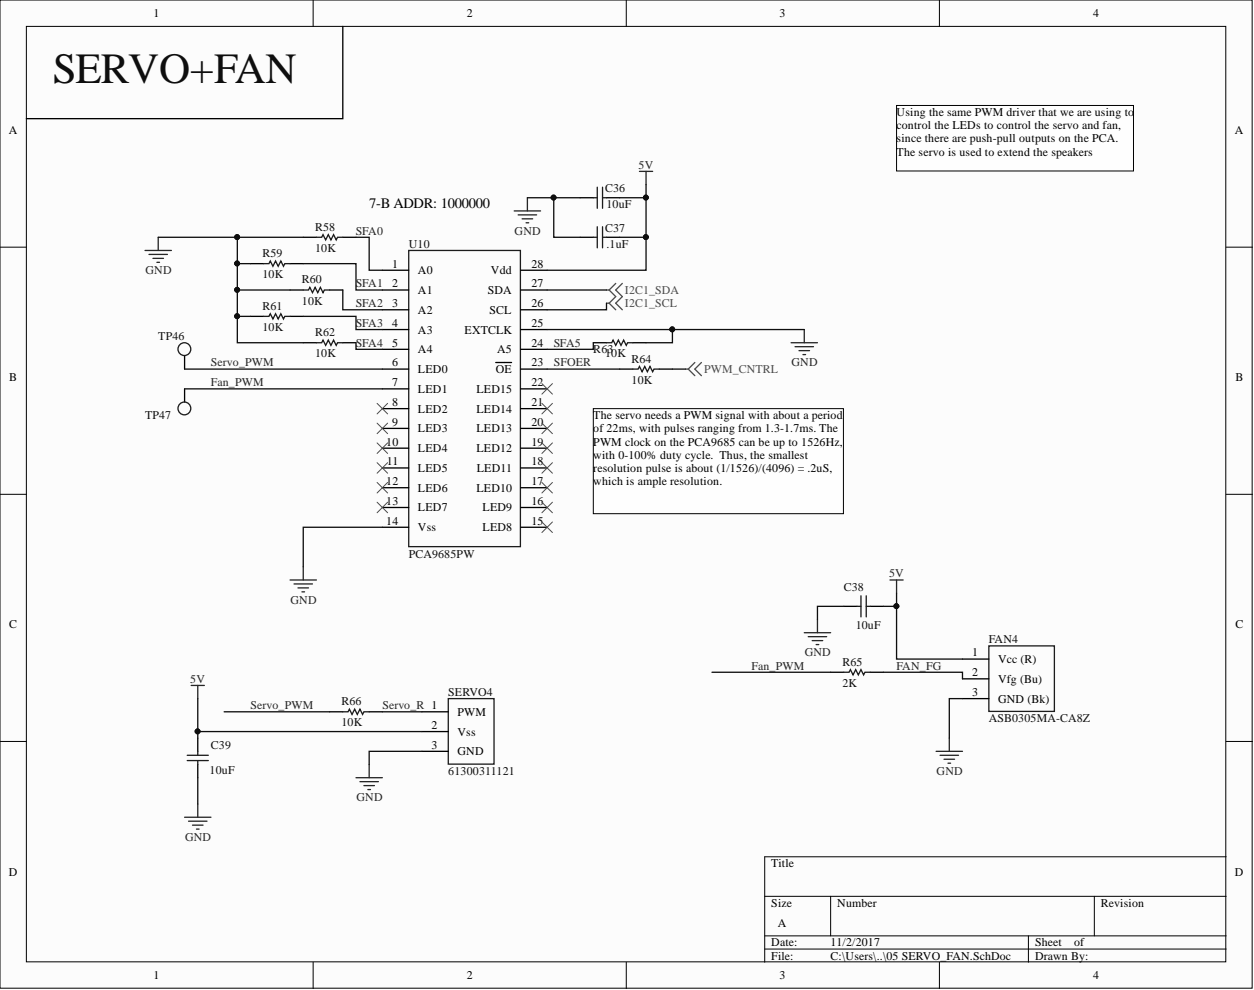
[picture p43: page 5]

Using the same PWM driver that we are using to
control the LEDs to control the servo and fan,
since there are push-pull outputs on the PCA.
The servo is used to extend the speakers

SFA2 | A2 3

The servo needs a PWM signal with about a period
of 22ms, with pulses ranging from 1.3-1.7ms. The
PWM clock on the PCA9685 can be up to 1526Hz,
with 0-100% duty cycle. Thus, the smallest
resolution pulse is about (1/1526)/(4096) = .2uS,
which is ample resolution.

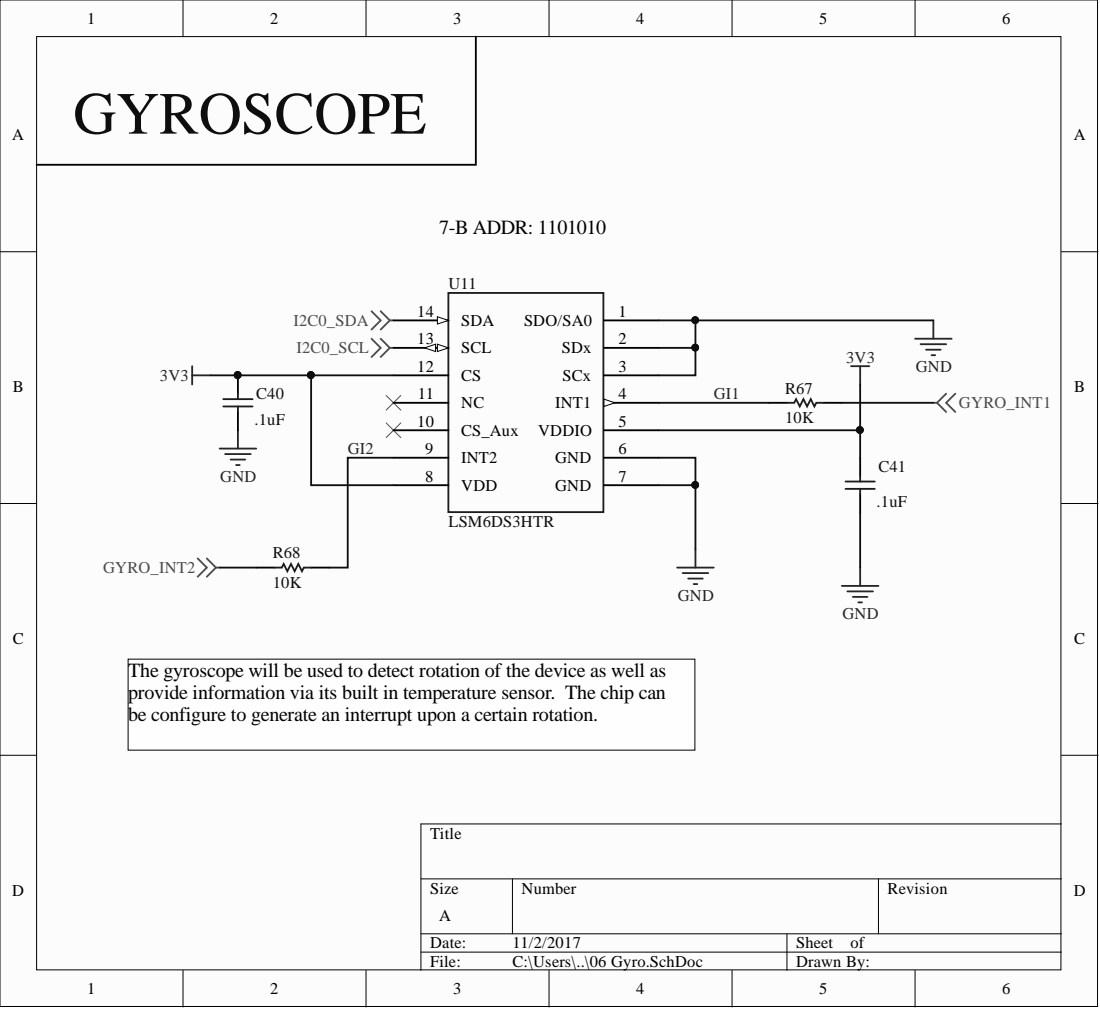
[picture p44: page 6]

The gyroscope will be used to detect rotation of the device as well as
provide information via its built in temperature sensor. The chip can
be configure to generate an interrupt upon a certain rotation.

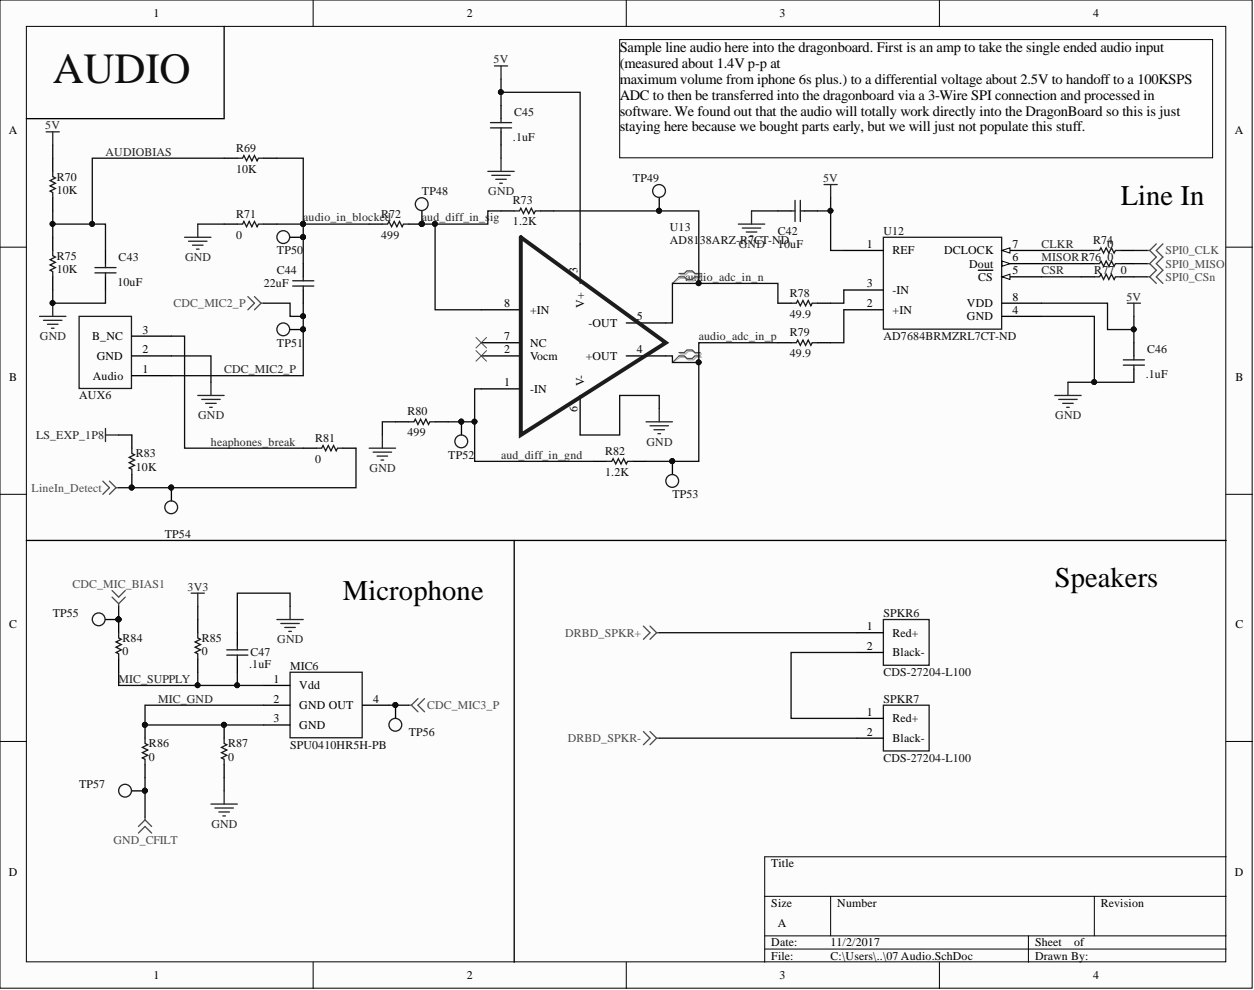
[picture p45: page 7]

Sample line audio here into the dragonboard. First is an amp to take the single ended audio input
(measured about 1.4V p-p at
maximum volume from iphone 6s plus.) to a differential voltage about 2.5V to handoff to a 100KSPS
ADC to then be transferred into the dragonboard via a 3-Wire SPI connection and processed in
software. We found out that the audio will totally work directly into the DragonBoard so this is just
staying here because we bought parts early, but we will just not populate this stuff.

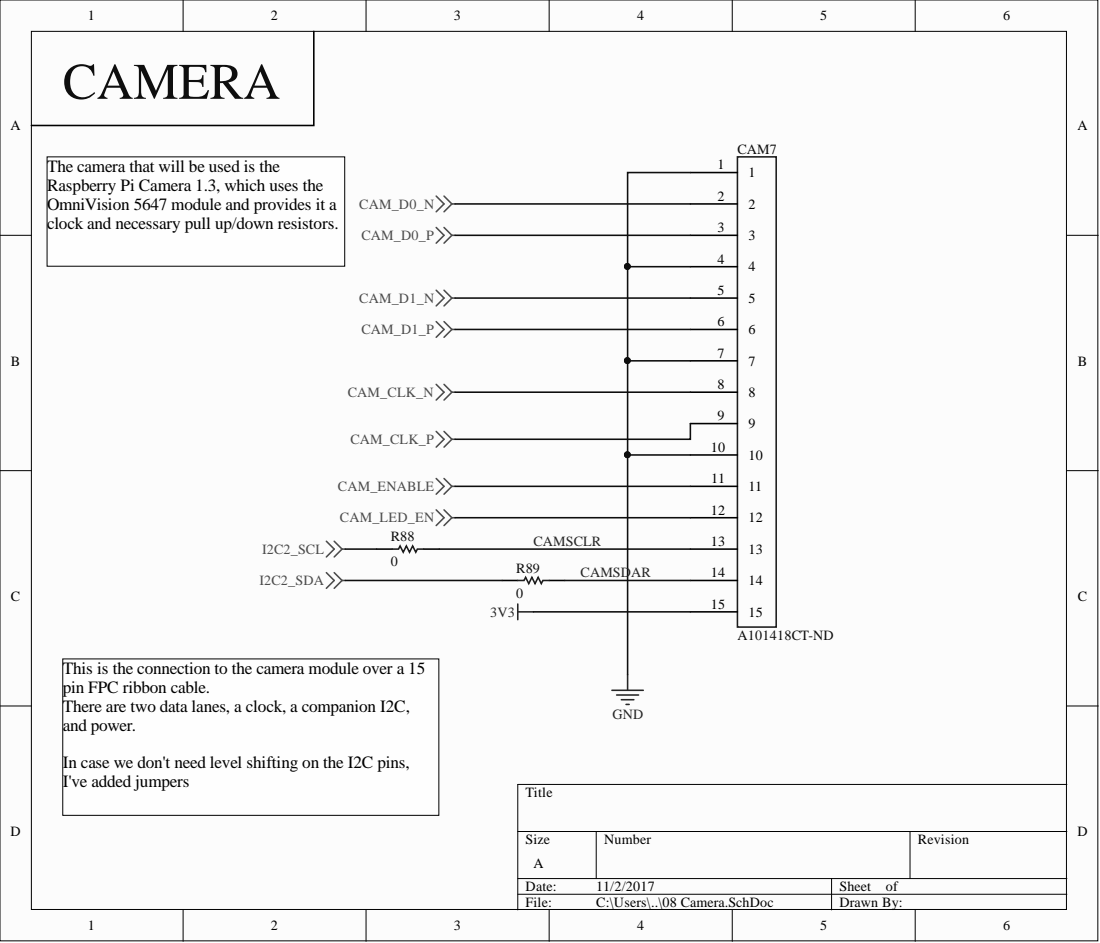
[picture p46: page 8]

The camera that will be used is the
Raspberry Pi Camera 1.3, which uses the
OmniVision 5647 module and provides it a
clock and necessary pull up/down resistors.

This is the connection to the camera module over a 15
pin FPC ribbon cable.
There are two data lanes, a clock, a companion I2C,
and power.

In case we don't need level shifting on the I2C pins,
I've added jumpers

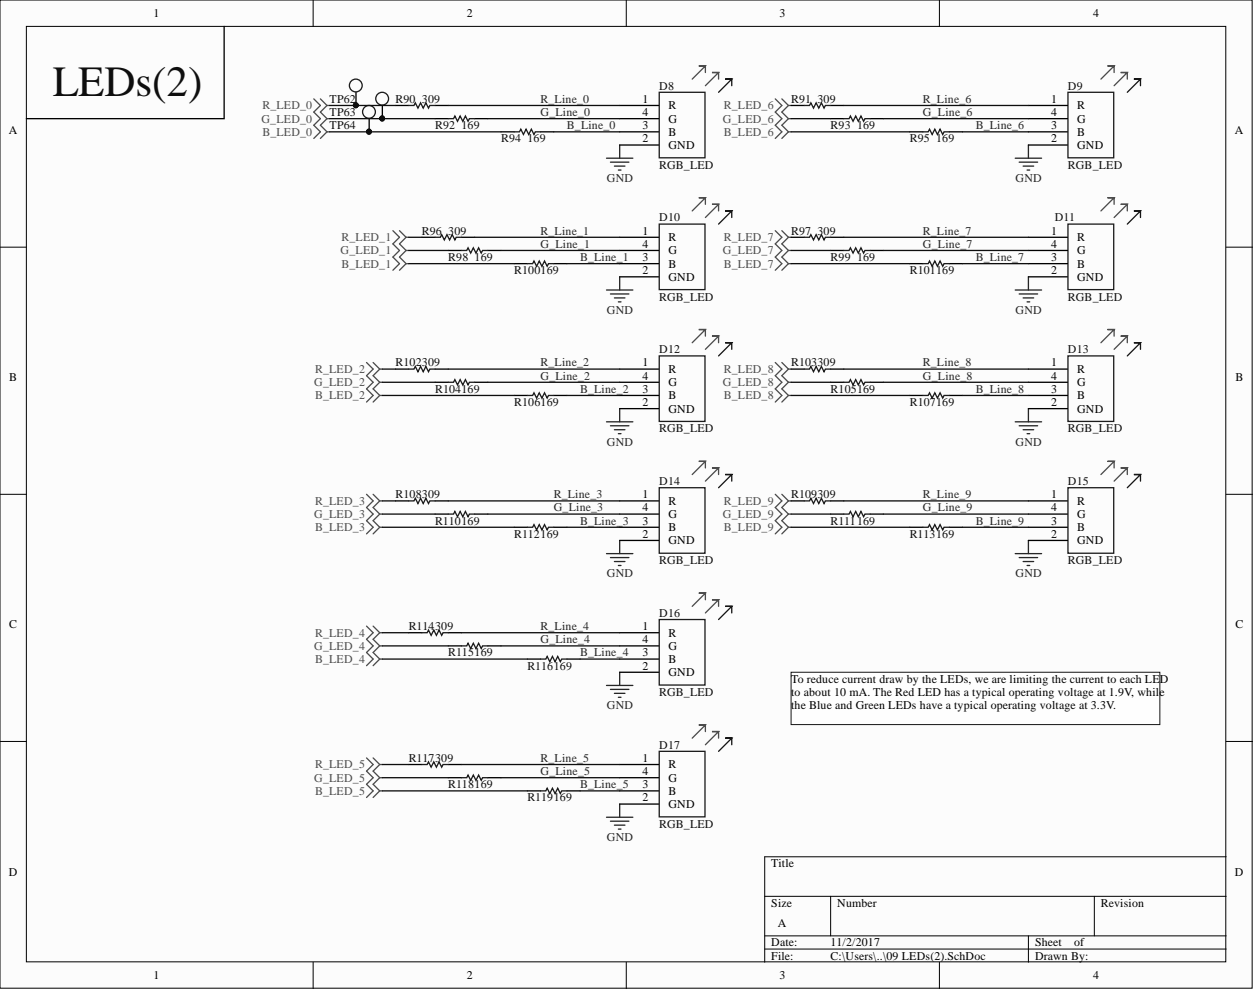
[picture p47: page 9]

To reduce current draw by the LEDs, we are limiting the current to each LED
to about 10 mA. The Red LED has a typical operating voltage at 1.9V, while
the Blue and Green LEDs have a typical operating voltage at 3.3V.
