sjfricke/MrTruman/ALTIUM/MRTRUMAN/Project Outputs for MRTRUMAN/Schematics_PDF.PDF

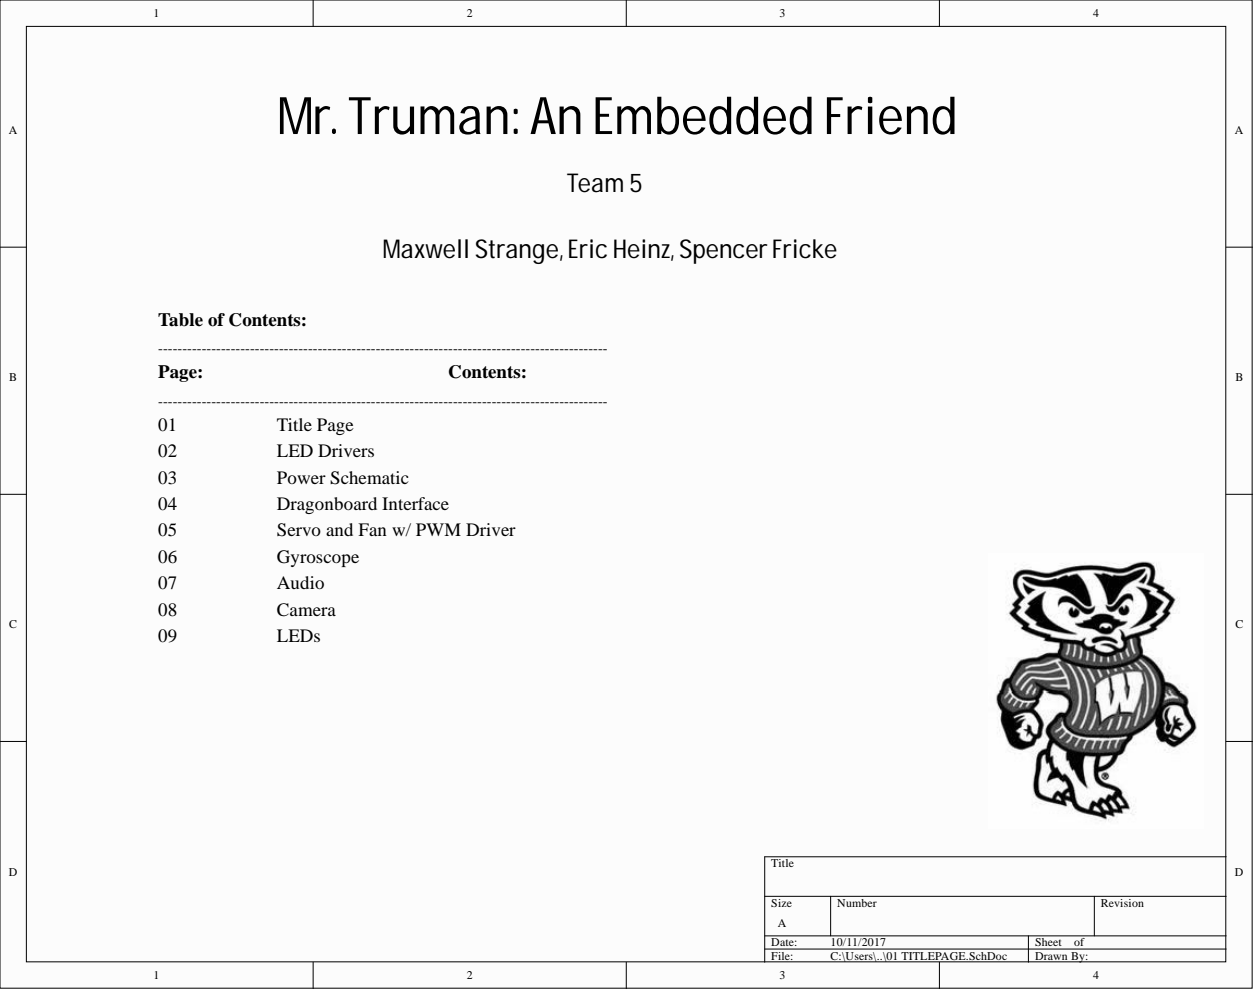
[picture p48: page 1]

Mr. Truman: An Embedded Friend

Maxwell Strange, Eric Heinz, Spencer Fricke

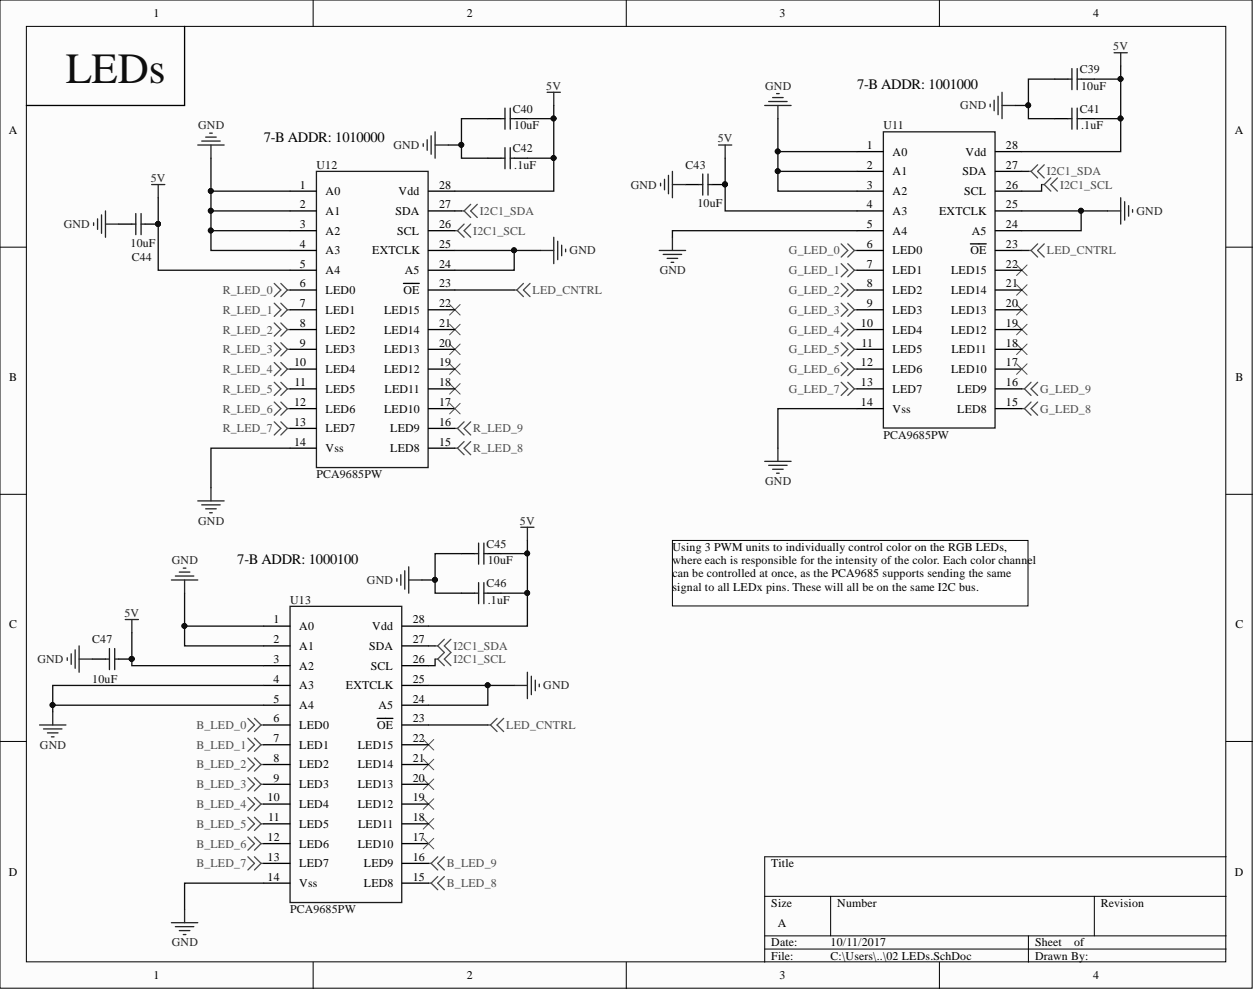
[picture p49: page 2]

Using 3 PWM units to individually control color on the RGB LEDs,
where each is responsible for the intensity of the color. Each color channel
can be controlled at once, as the PCA9685 supports sending the same
signal to all LEDx pins. These will all be on the same I2C bus.

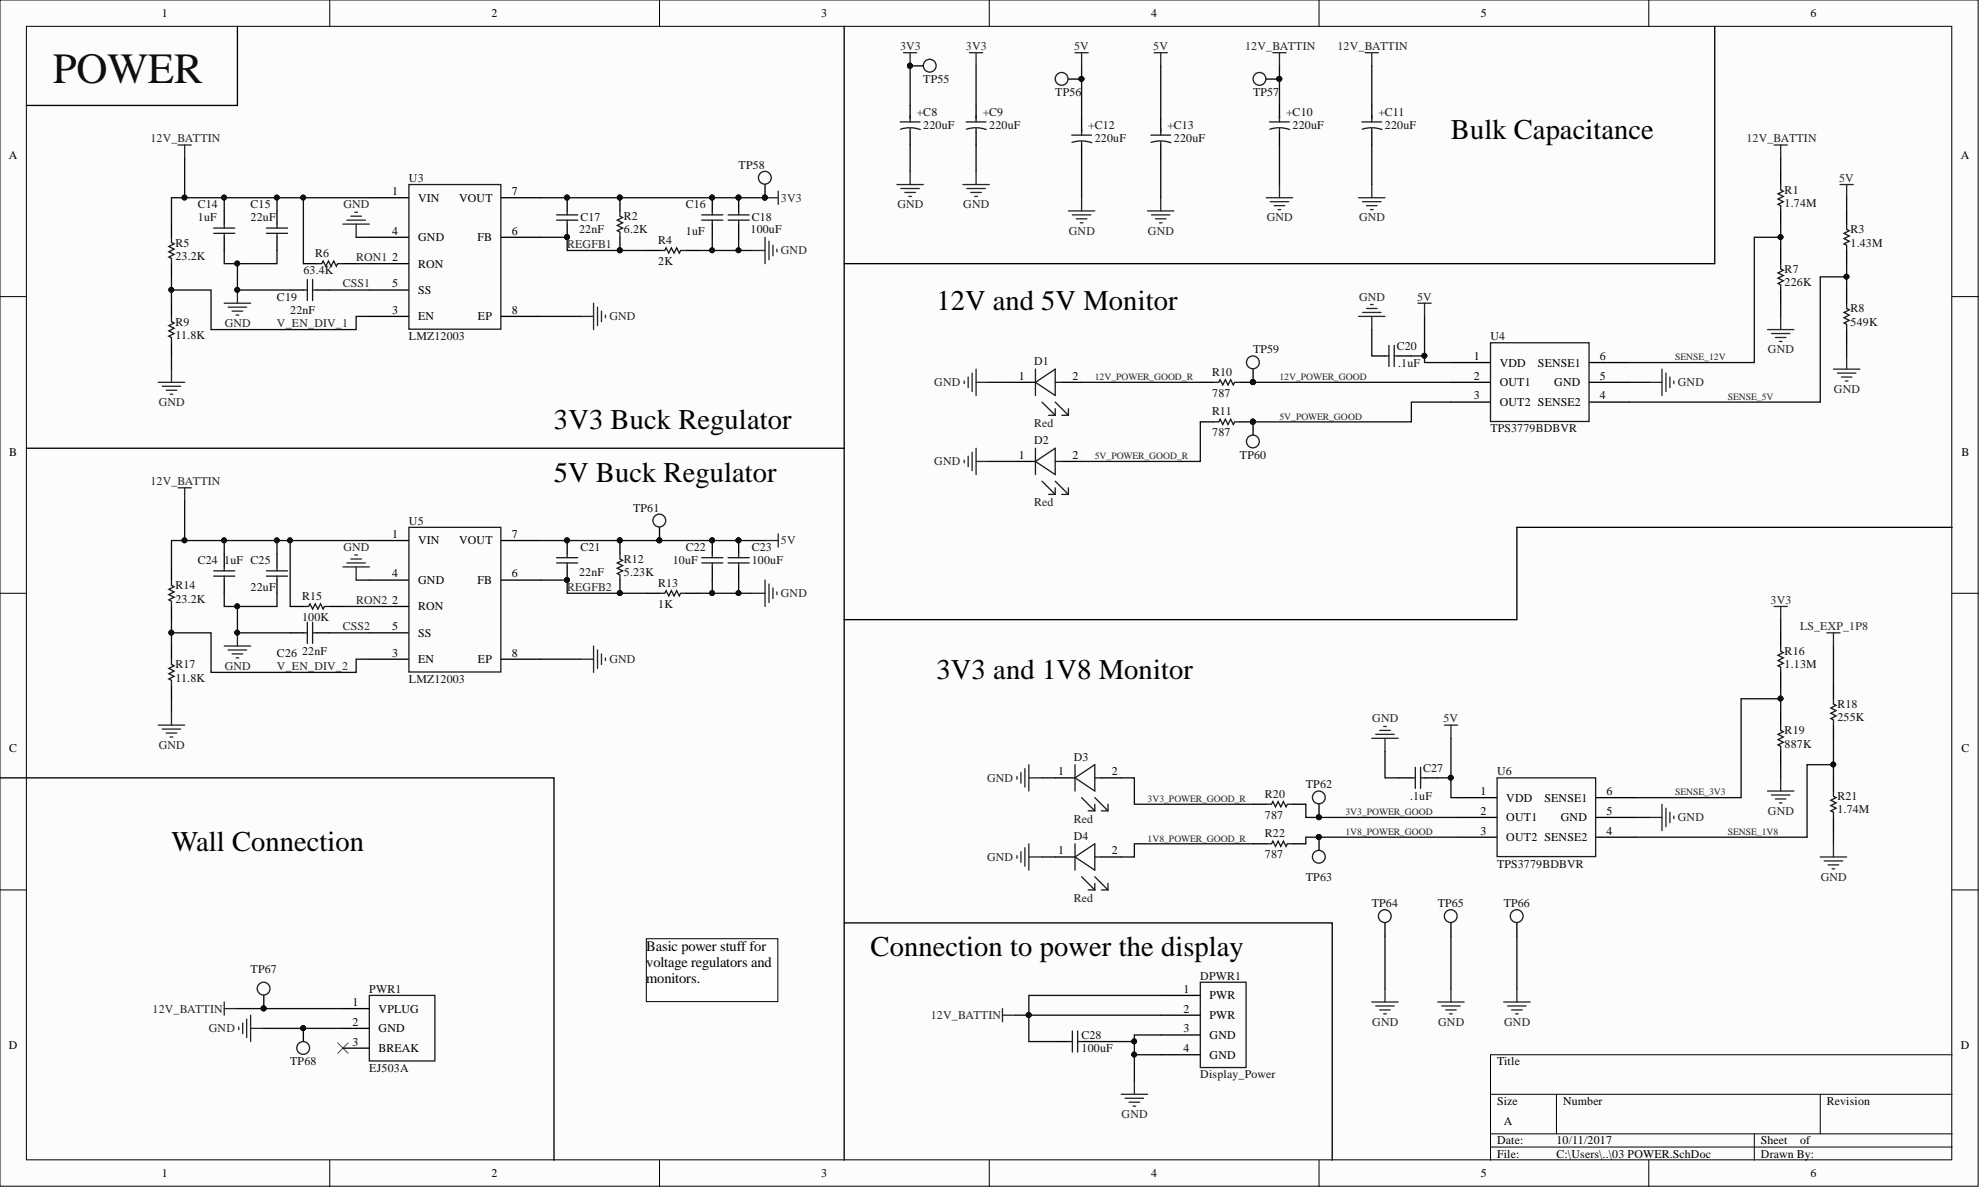
[picture p50: page 3]

G S ENS E_12V | N

5 | | S ENS E_5V

S ENS E_3V3

5 | S ENS E_1V8

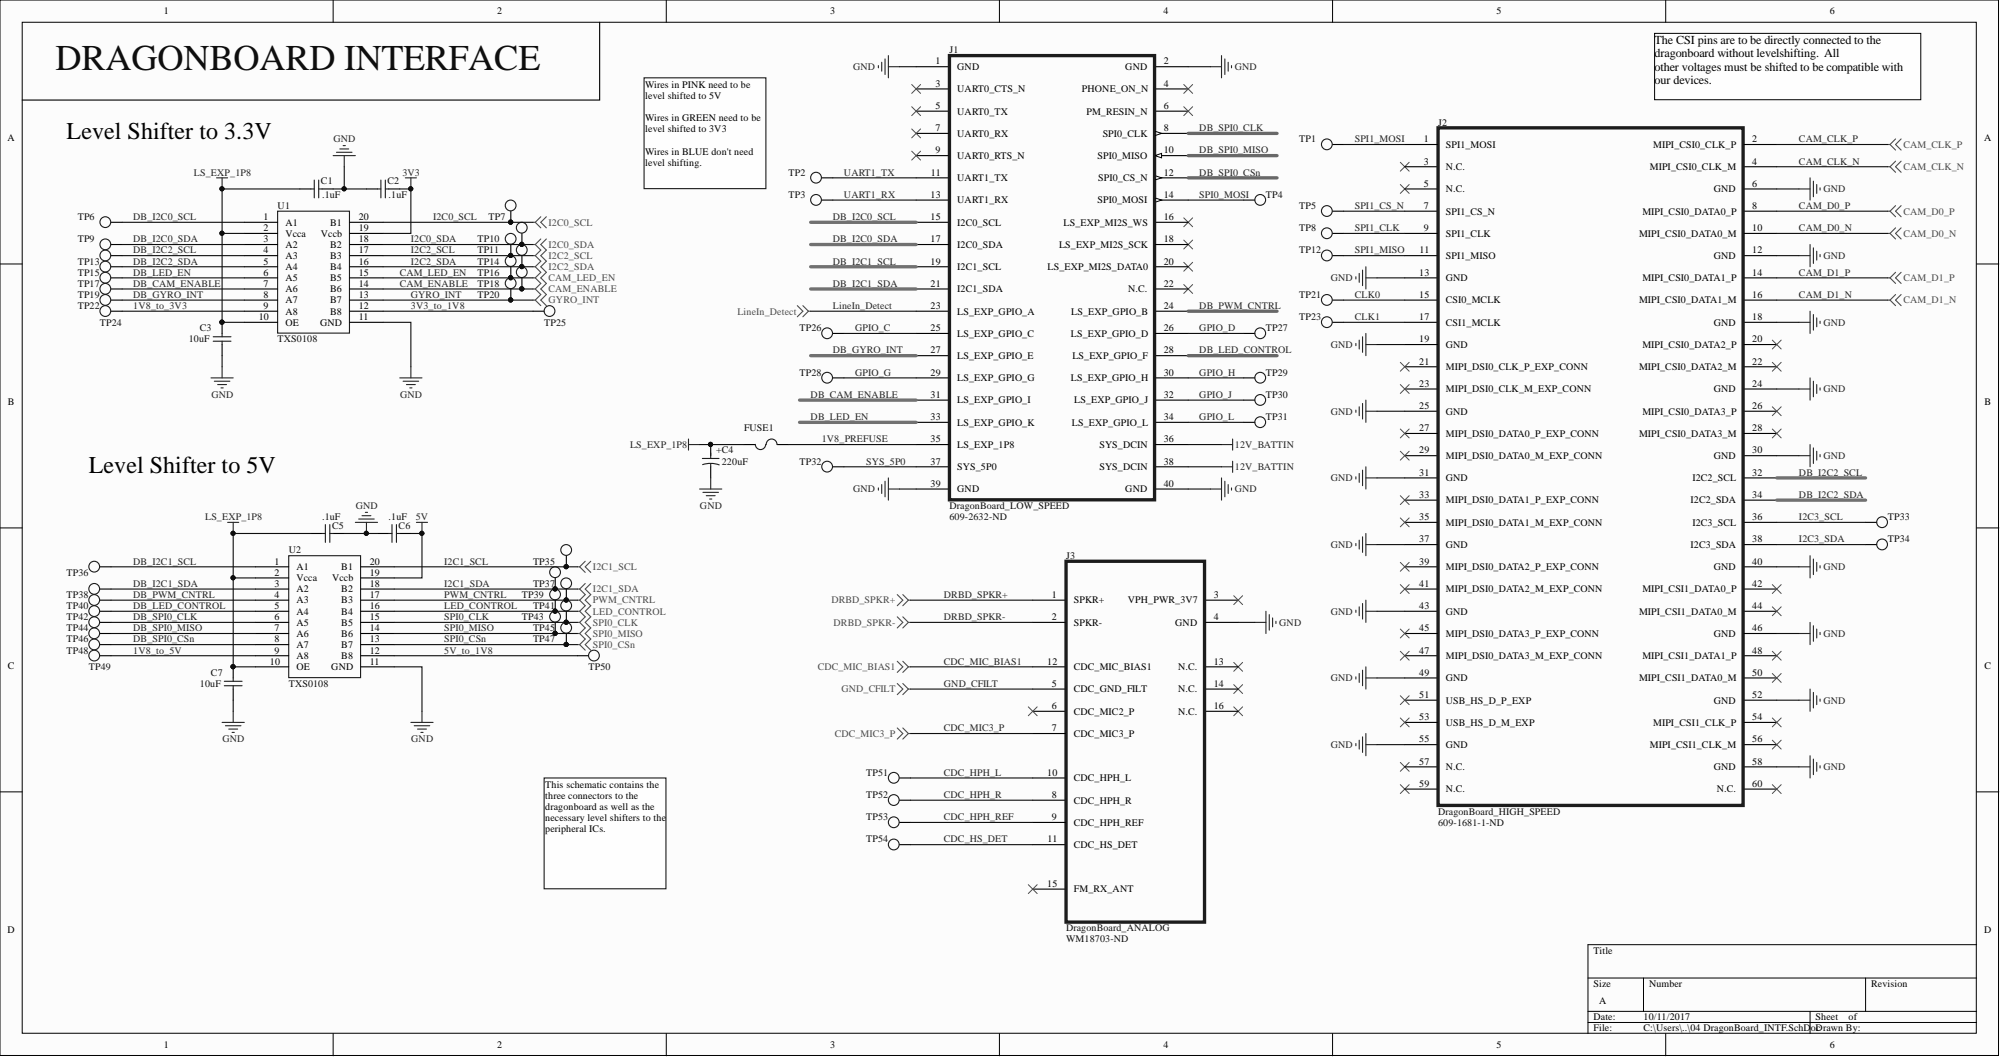
[picture p51: page 4]

A 1 Vcca | G N D
3 4 5 6 7 8 9 1 0 | A 2 A 3 A 4 A 5 A 6 A 7 A 8 O E | 1

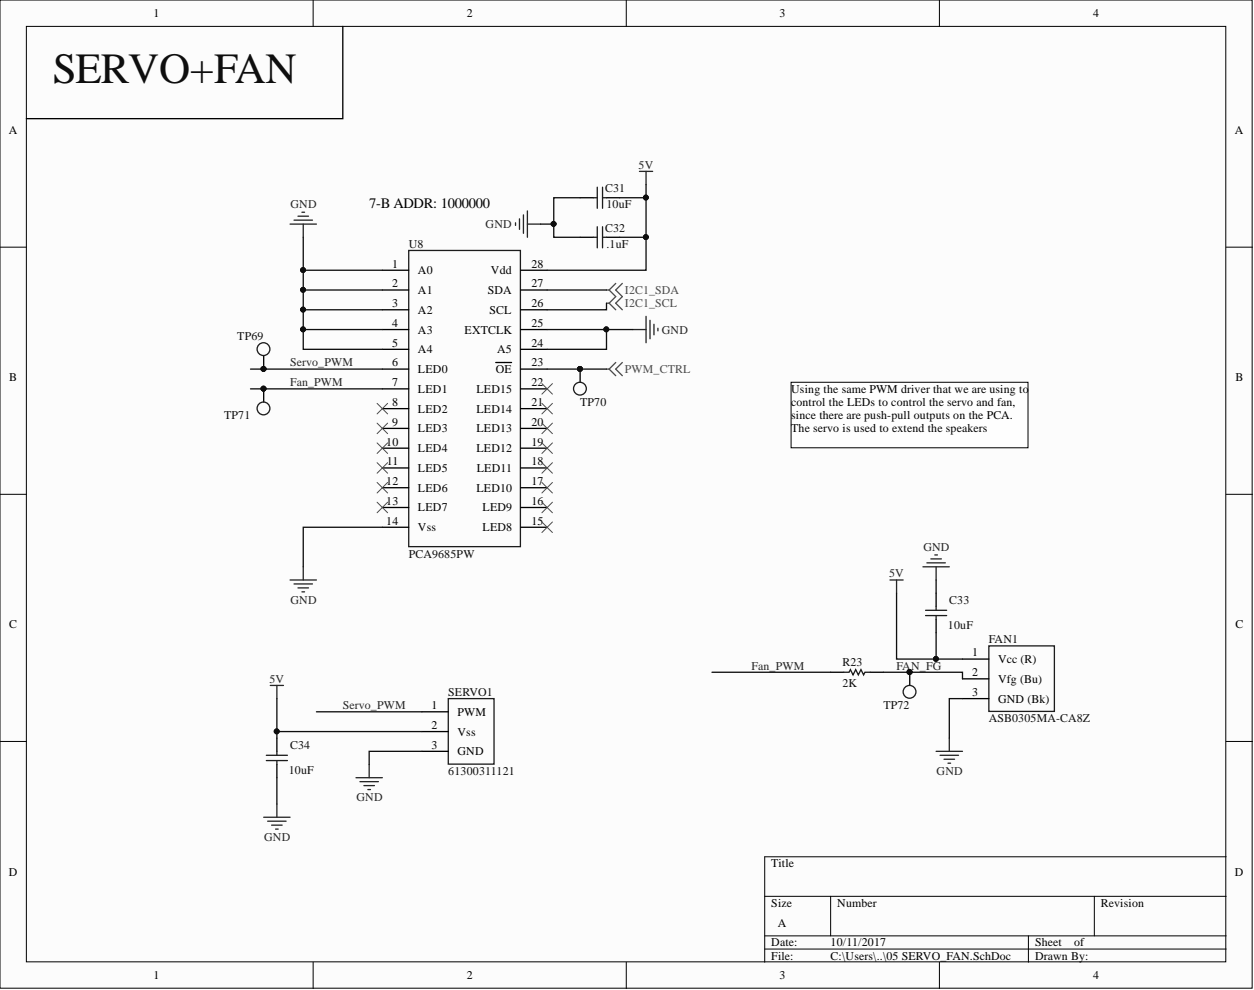
[picture p52: page 5]

Using the same PWM driver that we are using to
control the LEDs to control the servo and fan,
since there are push-pull outputs on the PCA.
The servo is used to extend the speakers

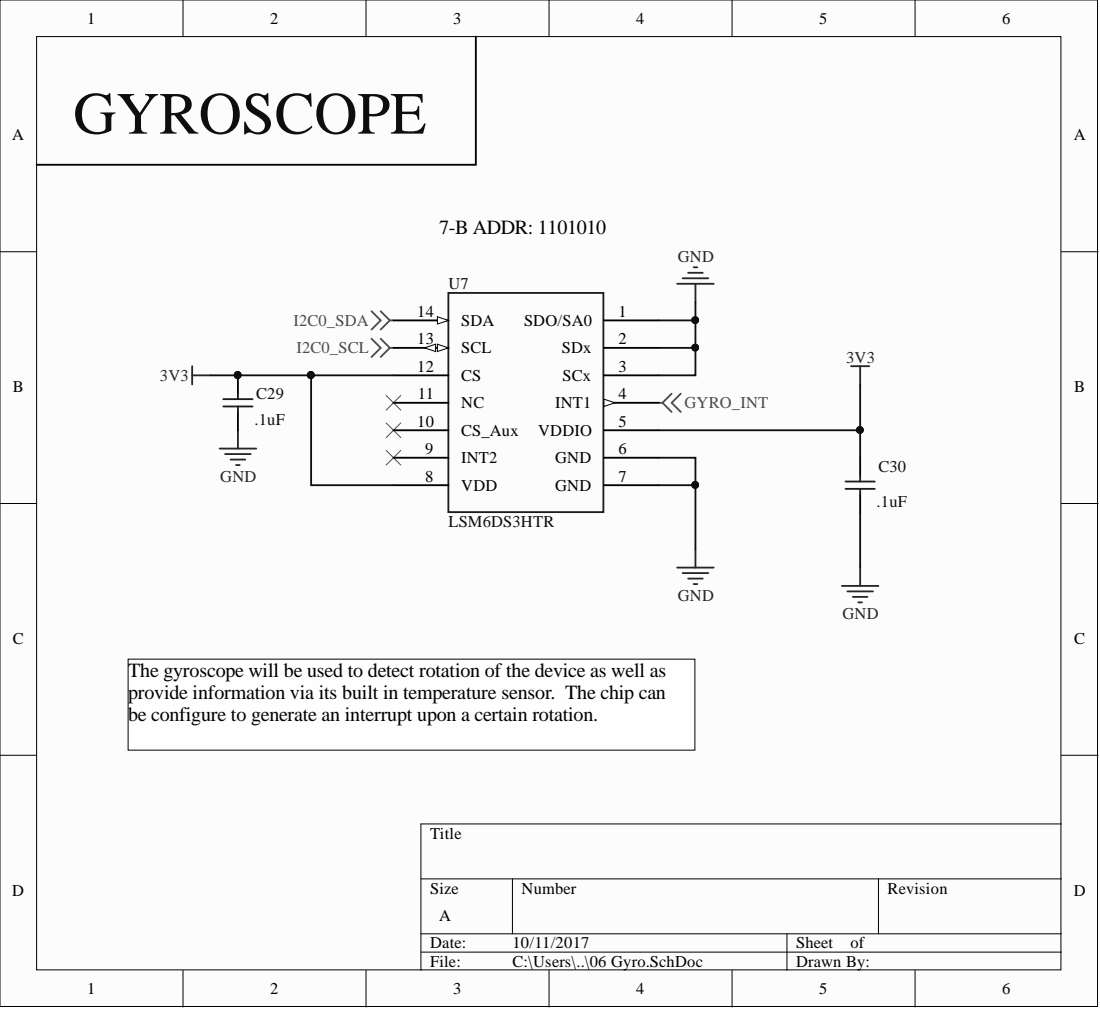
[picture p53: page 6]

1 1
1 0 | 5

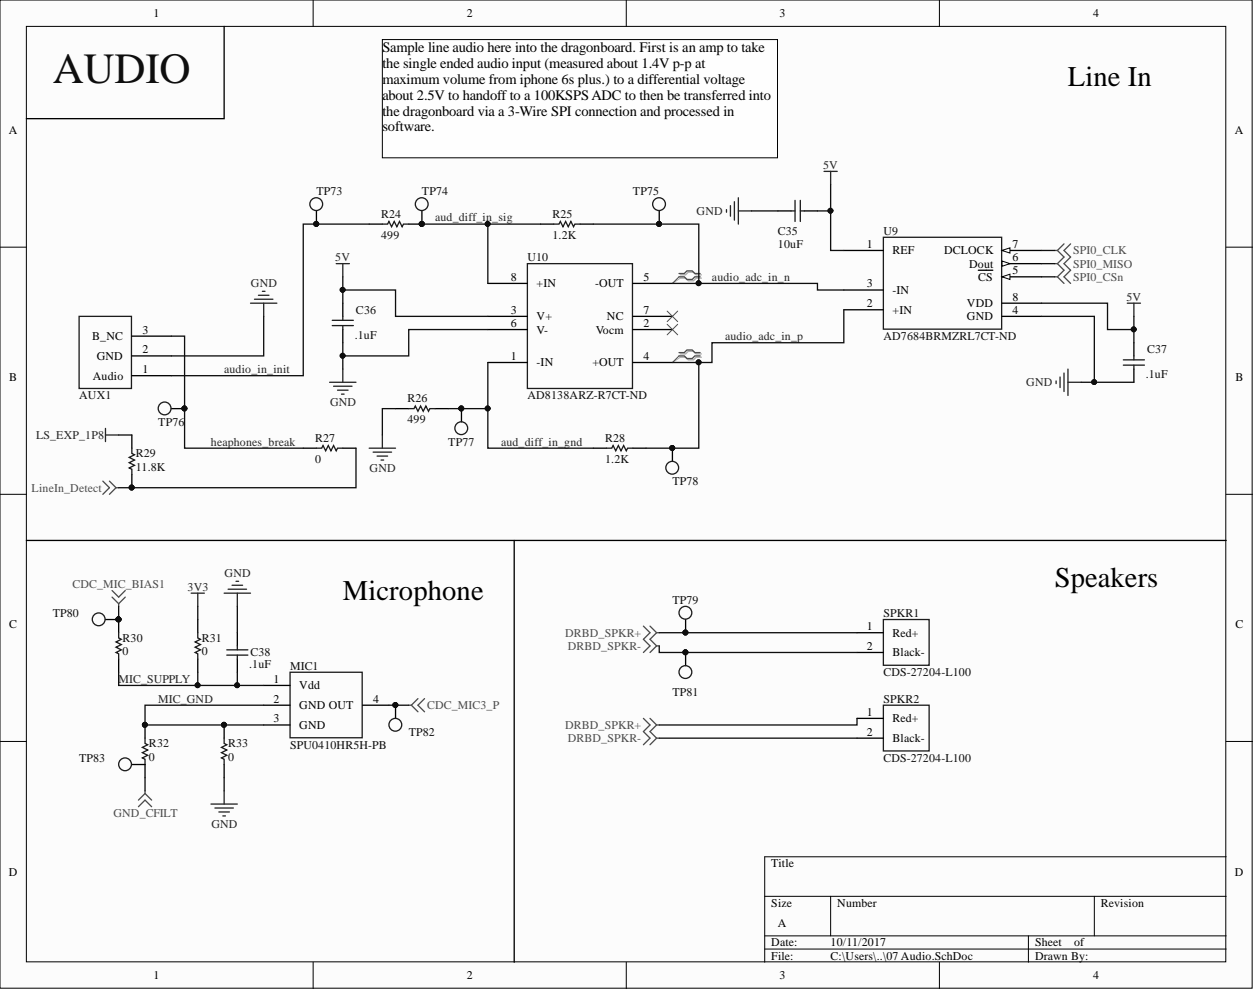
[picture p54: page 7]

Sample line audio here into the dragonboard. First is an amp to take
the single ended audio input (measured about 1.4V p-p at
maximum volume from iphone 6s plus.) to a differential voltage
about 2.5V to handoff to a 100KSPS ADC to then be transferred into
the dragonboard via a 3-Wire SPI connection and processed in
software.

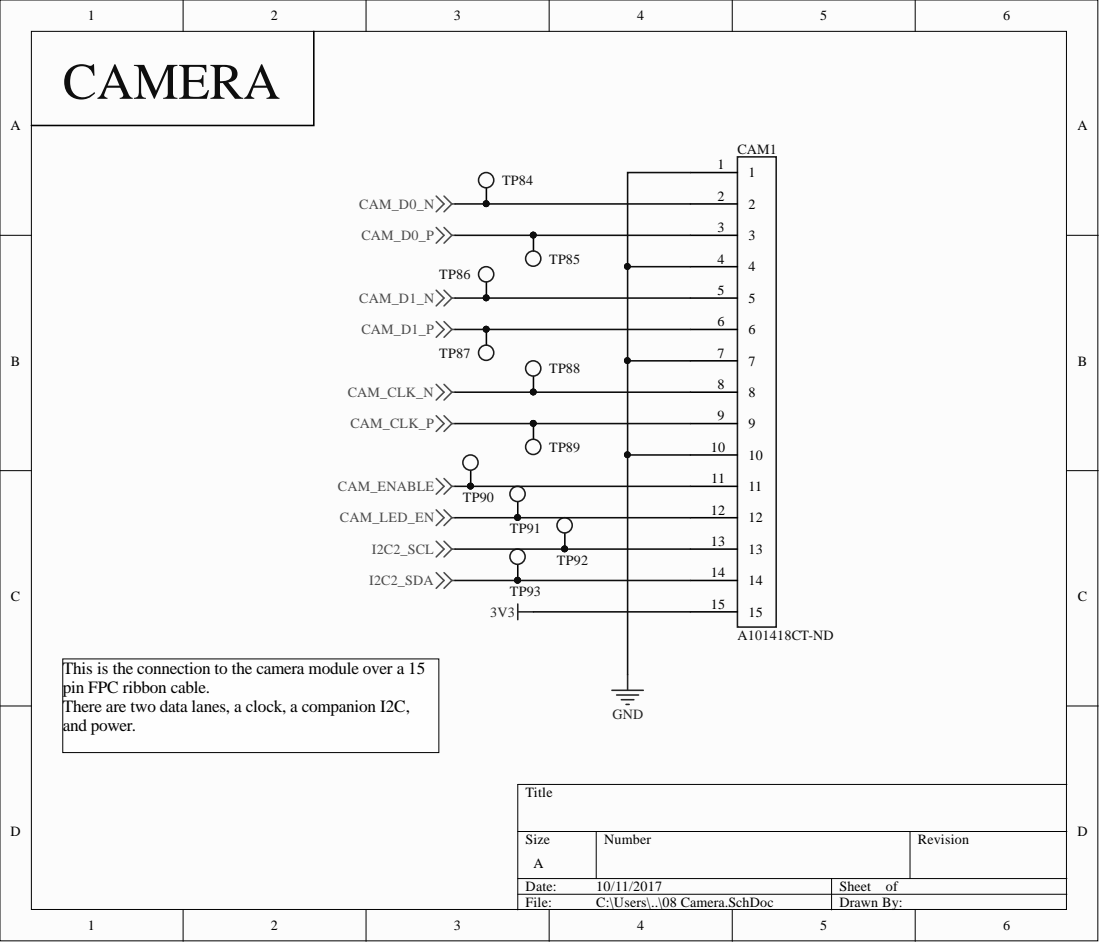
[picture p55: page 8]

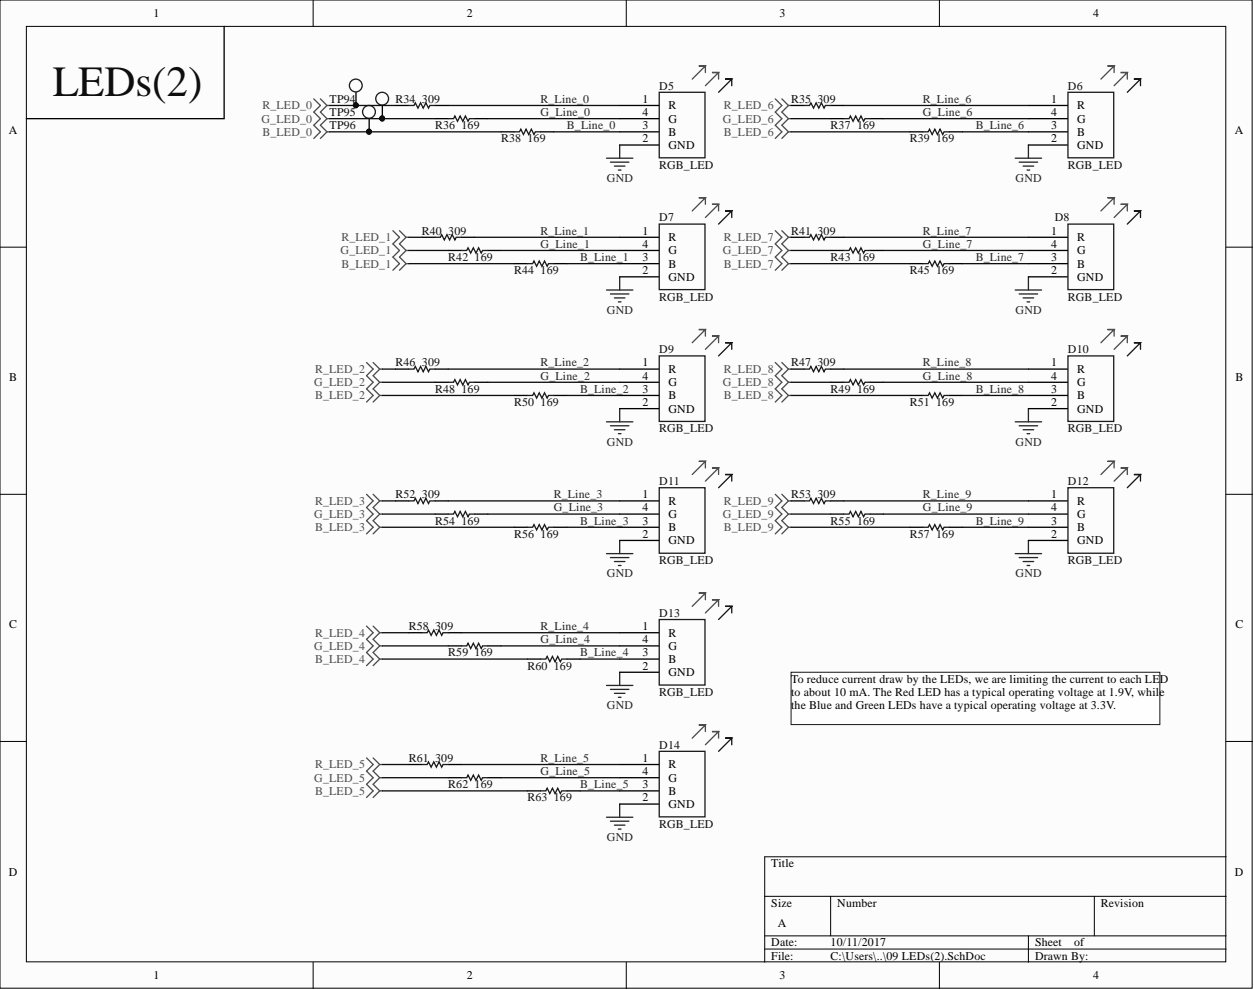
[picture p56: page 9]

To reduce current draw by the LEDs, we are limiting the current to each LED
to about 10 mA. The Red LED has a typical operating voltage at 1.9V, while
the Blue and Green LEDs have a typical operating voltage at 3.3V.
