sjfricke/MrTruman/(list of files, drawings)

Other design files:
ALTIUM/MRTRUMAN/01 LEDs.SchDoc
ALTIUM/MRTRUMAN/01 TITLEPAGE.SchDoc
ALTIUM/MRTRUMAN/02 LEDs.SchDoc
ALTIUM/MRTRUMAN/03 POWER.SchDoc
ALTIUM/MRTRUMAN/04 DragonBoard_INTF.SchDoc
ALTIUM/MRTRUMAN/05 SERVO_FAN.SchDoc
ALTIUM/MRTRUMAN/05 SERVO_FAN_LED.SchDoc
ALTIUM/MRTRUMAN/06 Gyro.SchDoc
ALTIUM/MRTRUMAN/07 Audio.SchDoc
ALTIUM/MRTRUMAN/08 Camera.SchDoc
ALTIUM/MRTRUMAN/09 LEDs(2).SchDoc
ALTIUM/MRTRUMAN/MRTRUMAN.PrjPcb
ALTIUM/MRTRUMAN/pcblib_truman.PcbLib
ALTIUM/MRTRUMAN/schlib_truman.SchLib
ALTIUM/MRTRUMAN/TRUMAN_PCB.PcbDoc
