sjfricke/MrTruman/Seahaven/status.h

// Everything here is global to keep status.
#include <stdint.h>
#define TRUE 1
#define FALSE 0

uint8_t animation_on;
uint8_t browser_connected;
uint8_t audio_plugged_in;
uint8_t local_volume;
uint8_t gyro_tripped;
uint8_t speaker_animation_ready;
uint8_t headphone_status;
uint8_t lights_on;
uint8_t audio_threshold;

uint16_t photo_index;
