sjfricke/MrTruman/Seahaven/test.c

#include "main.h"

static void testLEDFanServo() {

    servofanStart();
    servoRetract();
    fanOn(.99);
  
    initLEDs();
  
    int i;
    for(i = 0; i < 10; i++){
      setLED(PCA9685_ALL_CALL, .35, (1<<i));
      usleep(100000);
      setLED(PCA9685_ALL_CALL, 0, (1<<i));
      usleep(50000);
  
    }
  
    usleep(1000000);
    setLED(PCA9685_ALL_CALL, .35, 0x3FF);
    usleep(1000000);
    setLED(PCA9685_ALL_CALL, 0, 0x3FF);
  
    for(i = 0; i < 10; i++){
      setLED(PCA9685_RED_ADDRESS, .95, (1<<i));
      usleep(100000);
      setLED(PCA9685_RED_ADDRESS, 0, (1<<i));
      usleep(50000);
  
    }
  
    usleep(1000000);
    servoExtend();
    setLED(PCA9685_RED_ADDRESS, .85, 0x3FF);
    usleep(1000000);
    setLED(PCA9685_RED_ADDRESS, 0, 0x3FF);
   
  
  
    for(i = 0; i < 10; i++){
      setLED(PCA9685_BLUE_ADDRESS, .95, (1<<i));
      usleep(100000);
      setLED(PCA9685_BLUE_ADDRESS, 0, (1<<i));
      usleep(50000);
  
    }
  
    usleep(1000000);
    setLED(PCA9685_BLUE_ADDRESS, .65, 0x3FF);
    usleep(1000000);
    setLED(PCA9685_BLUE_ADDRESS, 0, 0x3FF);
  
  
  
    for(i = 0; i < 10; i++){
      setLED(PCA9685_GREEN_ADDRESS, .95, (1<<i));
      usleep(100000);
      setLED(PCA9685_GREEN_ADDRESS, 0, (1<<i));
      usleep(50000);
  
    }
  
    usleep(1000000);
    setLED(PCA9685_GREEN_ADDRESS, .65, 0x3FF);
    usleep(1000000);
    setLED(PCA9685_GREEN_ADDRESS, 0, 0x3FF);
  
  
  
  
    for(i = 0; i < 10; i++){
      setLED(PCA9685_GREEN_ADDRESS, .95, (1<<i)+(1<<(i+1)));
      setLED(PCA9685_BLUE_ADDRESS, .95, ( (1<<9)>>(i)) +((1<<9)>>(i+1)) );
      usleep(100000);
      setLED(PCA9685_GREEN_ADDRESS, 0, (1<<i)+(1<<(i+1)));
      setLED(PCA9685_BLUE_ADDRESS, 0, ( (1<<9)>>(i)) +((1<<9)>>(i+1)));
      usleep(50000);
  
    }
  
    usleep(1000000);
    setLED(PCA9685_GREEN_ADDRESS, .65, 0x3FF);
    usleep(1000000);
    setLED(PCA9685_GREEN_ADDRESS, 0, 0x3FF);
    fanOff();
    servoStop();
}

static void testGyro() {
    
    // turn on Gyro
    enableGyroTilt();


    // Gyro INT1 is on GPIO_E (pin 27 on dragonboard)
    //  Set GPIO_E dir as input
    //  Poll to determine when interrupted
    //
    //
    //
       //printf("using pin %s", pin);
    //printf(" with curr direction %d", GpioGetDirection(pin)); 
    //printf(" with GPIO val %d\n", GpioGetValue(pin));
    //GpioEnablePin(pin);
    //GpioSetDirection(pin, 0);

    //printf("Now direction is %d", GpioGetDirection(pin)); 
    //printf(" with GPIO val %d\n", GpioGetValue(pin));

    uint8_t data;

    uint16_t interrupt_pin;
    
    // enable tilt event detection, two LSB conclude two ops (idk what they are) 
    //I2cReadByte(LSM6DS3H_I2C_BUS, LSM6DS3H_FUNC_SRC, &data);
    //printf("data of interrupt status: %x\n", data);
    int interrupted = 0;

    while(1){
	
            double x_data = getXRotation();
            double y_data = getYRotation();
            double z_data = getZRotation();
	    printf("\rGYROX: %d \tGYROY: %d\tGYROZ: %d", x_data, y_data, z_data);

    }
    /*
    gyroClearInterrupt();
    while (1) {
        if (gyroInterruptPoll()) {
	    //printf("Detected int \n");
            interrupted++;
            data = gyroClearInterrupt();
            /*int16_t x_data = getGyroX();
            int16_t y_data = getGyroY();
            int16_t xlx_data = getAccelX();
            int16_t xly_data = getAccelY();
            int16_t xlz_data = getAccelZ();
            int16_t z_data = getGyroZ();
	   // printf("GYROX: %d \tGYROY: %d\tGYROZ: %d\tACCELX: %d\tACCELY: %d\tACCELZ: %d\n", x_data, y_data, z_data, xlx_data, xly_data, xlz_data);
	    //printf("GYROZ: %d\tACCELZ: %d\n", xlz_data, z_data);
	    int dir = getTiltDirection();
	    if (dir == 1 ){
		    printf("tilted right\n");
		    setLED(PCA9685_RED_ADDRESS, .9, 0x3ff);	    
	    }
	    else if (dir == -1) {
		    printf("tilted left\n");
		    setLED(PCA9685_GREEN_ADDRESS, .3, 0x3ff);	    
	    }else{
		    printf("neither\n");
		    setLED(PCA9685_BLUE_ADDRESS, .3, 0x3ff);	    
	    }
	    /*printf("\n");
            printf("gyro read x %d\n", x_data);
            printf("gyro read y %d\n", y_data);
            printf("accel read x %d\n", xlx_data);
            printf("accel read y %d\n", xly_data);
	    usleep(100000);
	    gyroClearInterrupt();
	    setLED(PCA9685_ALL_CALL, 0, 0x3ff);
        }
    }*/

    //I2cReadByte(LSM6DS3H_I2C_BUS, LSM6DS3H_FUNC_SRC, &data);
    //printf("data of interrupt status: %x\n", data);
    //printf("GPIO val %d\n", GpioGetValue(pin));
    // clear 
    I2cReadByte(LSM6DS3H_I2C_BUS, LSM6DS3H_FUNC_SRC, &data);
    //printf("FUNC_SRC reg is 0x%x", data);
    //printf("\nGRYO INT1 DETECTED\n");
}

static int testCamera() {
  printf("\nTesting Camera\n");
}

int main ( int argc, char* argv[] ) {
  printf("test\n");
  //testGyro();
  //testLEDFanServo();
  //testCamera();
  /*
  initLEDs();
  initAuxGPIO();
  loopbackSetup();
  loopback();
  */
  //
  
  servofanStart();
  servoExtend();
  sleep(1);
  servoRetract();
}
