sjfricke/MrTruman/(commit log)

2016-11-03 Gyro enables GPIO on enable function
2016-11-03 camera init file
2016-11-03 gyro works now
2017-11-06 init v2
    [01 LEDs.SchDoc, 01 TITLEPAGE.SchDoc, 02 LEDs.SchDoc, 03 POWER.SchDoc, 04 DragonBoard_INTF.SchDoc, 05 SERVO_FAN.SchDoc, 05 SERVO_FAN_LED.SchDoc, 06 Gyro.SchDoc]
2017-11-06 added code to test gyro tilt interrupts
2017-11-06 testing gyro code
2017-11-07 added schematics to repo
2017-11-07 refactored servo code
    tested with make test and works
2017-11-09 Hopfully working ov5647 module
    Needed fixed device tree to run it first though
2017-11-11 added bash script for audio on boot, leds init in loopback
2017-11-11 threading in loopback
2017-11-11 playing around with LED sync
2017-11-13 driver tar for cam
2017-11-13 fixed gpio to use uint not char
    [gyro.c, servo.c]
2017-11-14 audio recovery on broken pipe
    [loopback.c, test.c]
2017-11-14 sourced some fft code, have sample data - just need to run
2017-11-15 tasty led sync
2017-11-15 servo extends 180 degrees now over about 2 seconds
2017-11-16 fixed issue where broken pipe would break LED control
    [loopback.c, test.c]
2017-11-17 refactored, added some gyro functionality
2017-11-17 Fixed build Max broke
    Shame on whole family
    [gyro.c]
2017-11-17 filter code
2017-11-17 filter not gonna work
2017-11-20 gyro and accel x,y read
2017-11-20 tilt direction somewhat working, fails for some movements
    [LSM6DS3H.h, gyro.c, test.c]
2017-11-20 gyro tilt working, left, right, only being printed for relevant rotations. Thanks MachineLearnginTensorFlowNeuralNets
2017-11-20 gyro direction is now broadcast
2017-11-21 cleaner trinary for broadcast string
    No reason to waste time malloc, also malloc of power of 2
2017-11-22 Start of board drafted for 3d model
    [final_v1.blend]
2017-11-22 PCB model done
    [final_v1.blend, final_v1_PCB.stl]
2017-11-23 more well-defined utterances, speaker cabinet model from blender
    [max.blend]
2017-11-23 house outline made
    [final_v1_HOUSE.blend, final_v1_PCB.blend]
2017-11-23 Preview-able model'
    [final_v1_FINISH.blend, final_v1_HOUSE.blend]
2017-11-23 servo screw fix
    [final_v1_FINISH.blend]
2017-11-25 light switch works from idle
2017-11-27 First print drafts ready
    [House_backplates.curaproject.3mf, House_front_cura.curaproject.3mf, awning.stl, back_plate_full.stl, back_plate_left.stl, back_plate_right.stl, final_v1_FINISH.blend, final_v1_HOUSE.blend]
2017-11-27 trying to pull
    [max.blend]
2017-11-27 fan stuff
2017-11-28 fixed audio blocking issue after animation
    [voice.c]
2017-11-28 gyro setup
2017-11-28 fixed servo rotation. When aux plugged it they extract, when not they retract
    [PCA9685.h, main.c, servo.c]
2017-11-29 v1 of final draft printing
    [House_Backplates_v2.curaproject.3mf, House_backplates.curaproject.3mf, awning.stl, back_plate_left.stl, back_plate_left2.stl, back_plate_left_test.stl, back_plate_right.stl, back_plate_right2.stl]
2017-11-29 updated language model and gyro command
2017-12-01 pca and main fixes
    [PCA9685.h, main.c, test.c]
2017-12-04 Reduced background footprint and added temp
2017-12-04 fixed timing of animationms
    [main.c]
2017-12-04 servo weirdness
2017-12-06 removed screen driver
2017-12-08 added power off
2017-12-10 servo protection
2017-12-10 servo safety seems to work
2017-12-10 speakers and gyro work on start
2017-12-10 camera film jaz
2017-12-10 trying to fix weird audio issue
    [loopback.c, sound_clip.c]
2017-12-10 removed retracting servo in halt/reboot. It wouldnt retract but would write zero to file
    [loopback.c, main.c, sound_clip.c]
2017-12-11 servo rotation
2017-12-11 fixed servo timing and default speaker animation pulse
    [PCA9685.h, main.c]
2017-12-13 Changed i_did_not to mono 16 bit 44100hz
